juniper-garden/twig_temp_humidity_sensor/a-SEM-of-PTFE-tape-TaegaSeal-and-b-PTFE-membrane-Millipore-Although-PTFE-tape.png

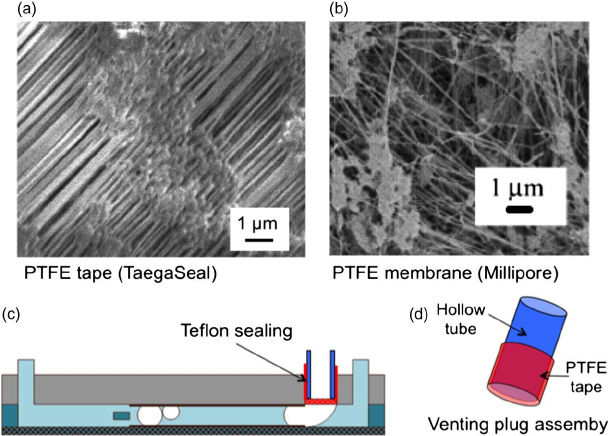
a-SEM-of-PTFE-tape-TaegaSeal-and-b-PTFE-membrane-Millipore-Although-PTFE-tape.png
