juniper-garden/twig_temp_humidity_sensor/temp sensor.png

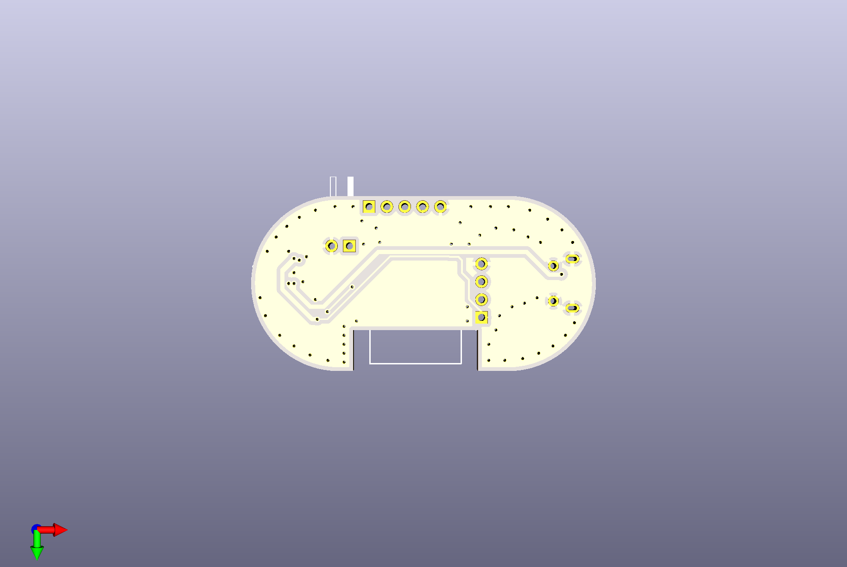
temp sensor.png
