juniper-garden/twig_temp_humidity_sensor/README.md

# twig_temp_humidity_sensor
Hardware files for the temperature and humidity sensor
