juniper-garden/twig_temp_humidity_sensor/Capture.PNG

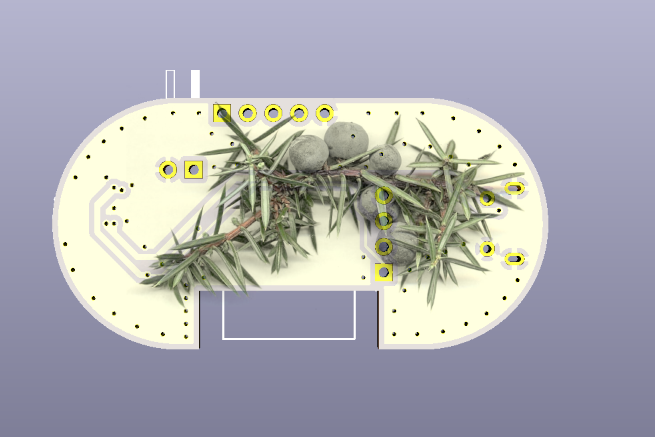
Capture.PNG
