juniper-garden/twig_temp_humidity_sensor/esp32 alignment error.PNG

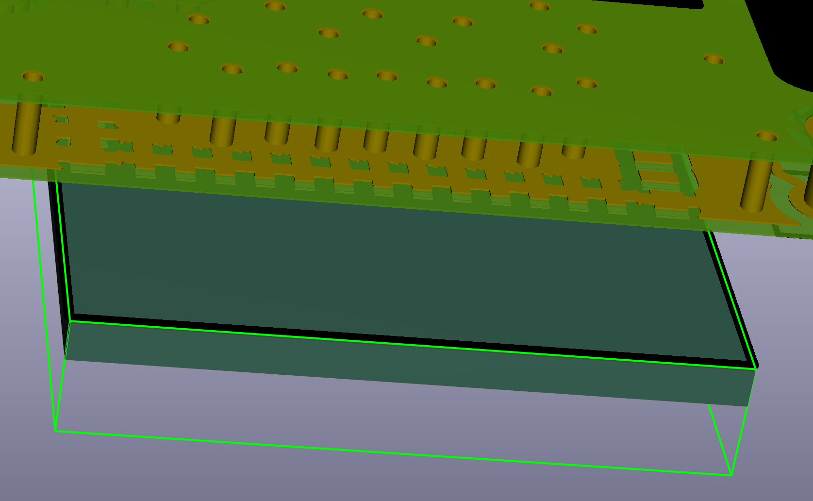
esp32 alignment error.PNG
