juniper-garden/twig_temp_humidity_sensor/gerbers.png_Combined_Bottom.png

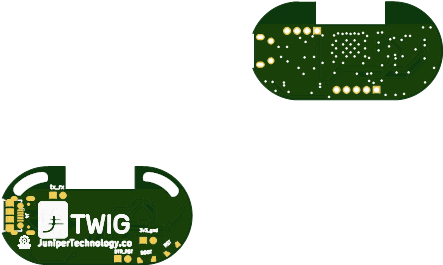
gerbers.png_Combined_Bottom.png
