juniper-garden/twig_temp_humidity_sensor/gerbers.png_Combined_Top.png

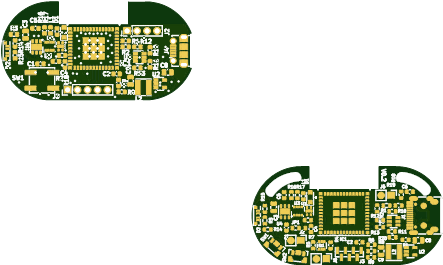
gerbers.png_Combined_Top.png
