juniper-garden/twig_temp_humidity_sensor/overmold notes.PNG

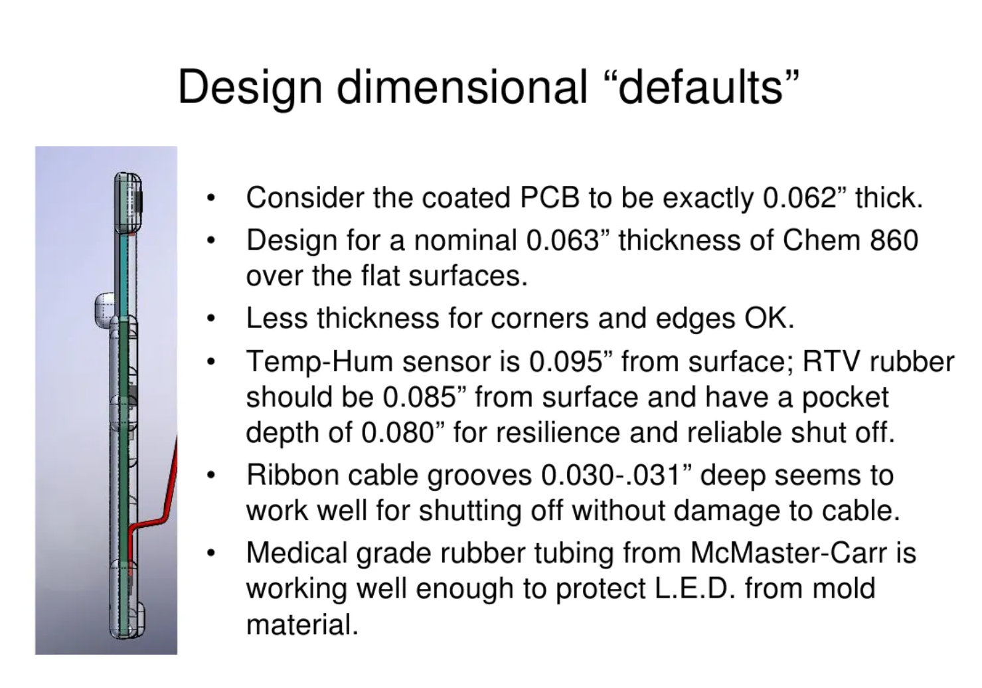
overmold notes.PNG
