juniper-garden/twig_temp_humidity_sensor/overmolding/overmolding suggestions.png

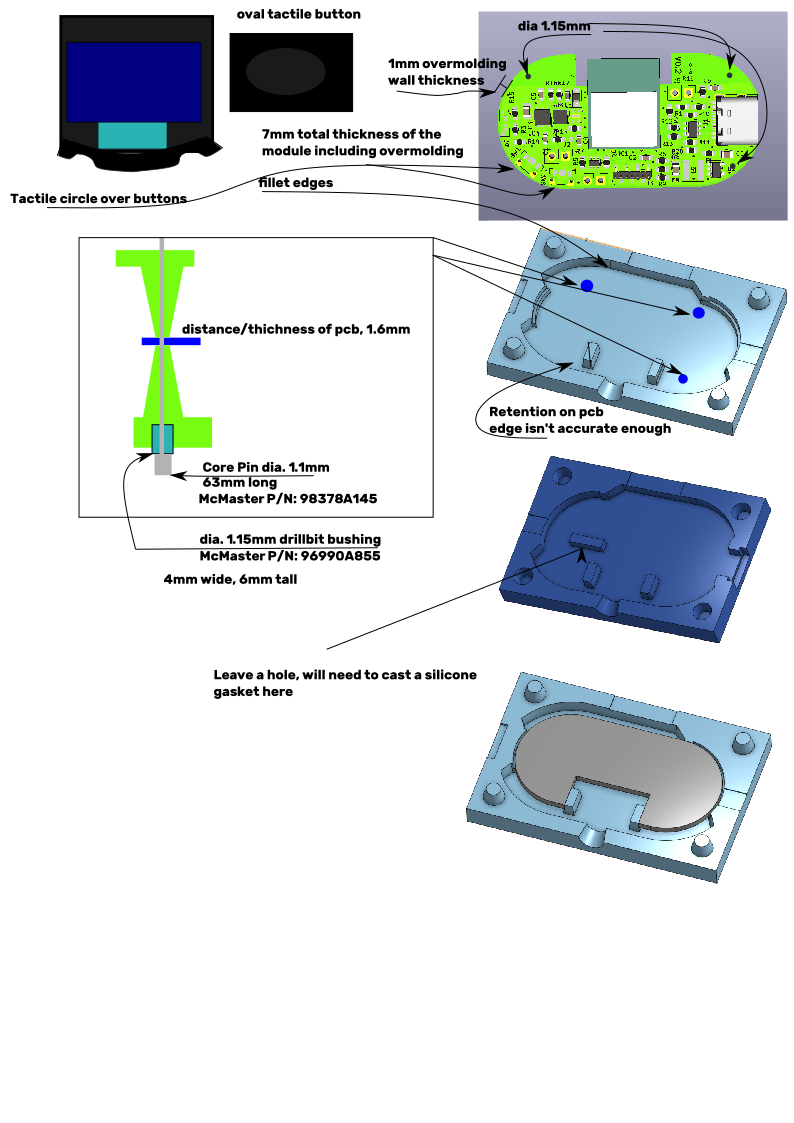
overmolding/overmolding suggestions.png
