juniper-garden/twig_temp_humidity_sensor/overmolding/tek bond 7718.jpg

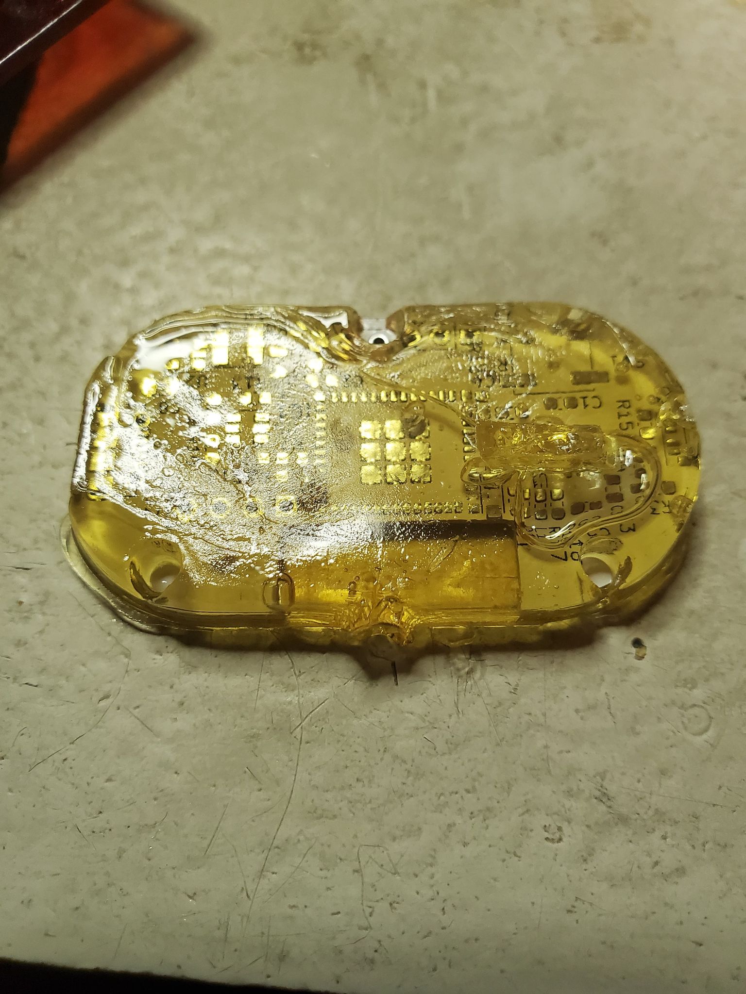
overmolding/tek bond 7718.jpg
