juniper-garden/twig_temp_humidity_sensor/panelized/frame/frame settings.PNG

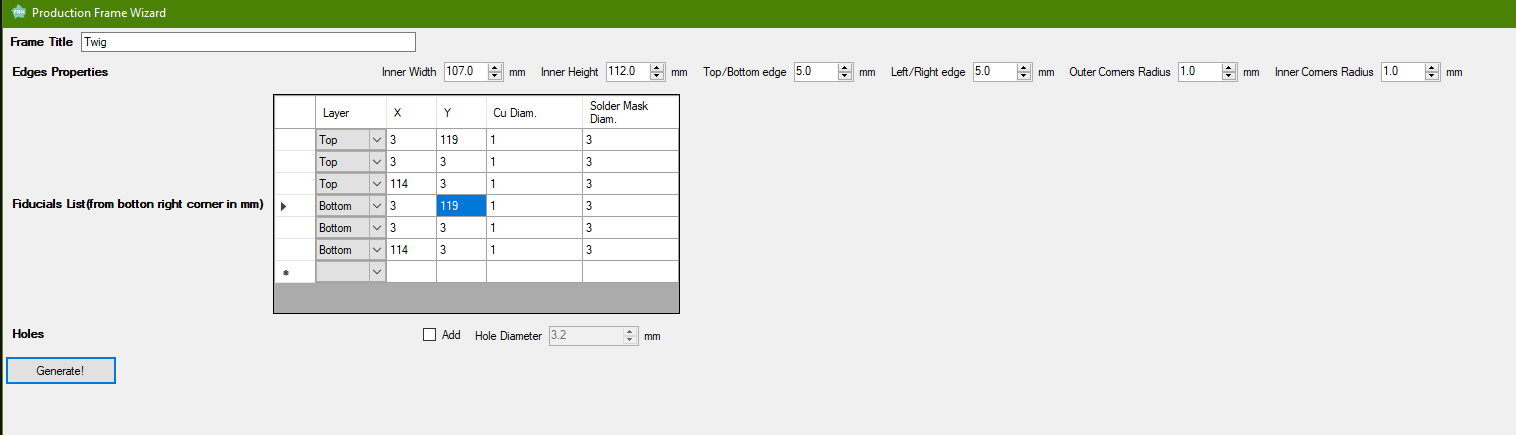
panelized/frame/frame settings.PNG
