juniper-garden/twig_temp_humidity_sensor/panelized/frame/twig frame_bottom_XRAY.png

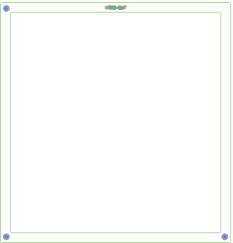
panelized/frame/twig frame_bottom_XRAY.png
