juniper-garden/twig_temp_humidity_sensor/panelized/twig_panelized_Combined_Top.png

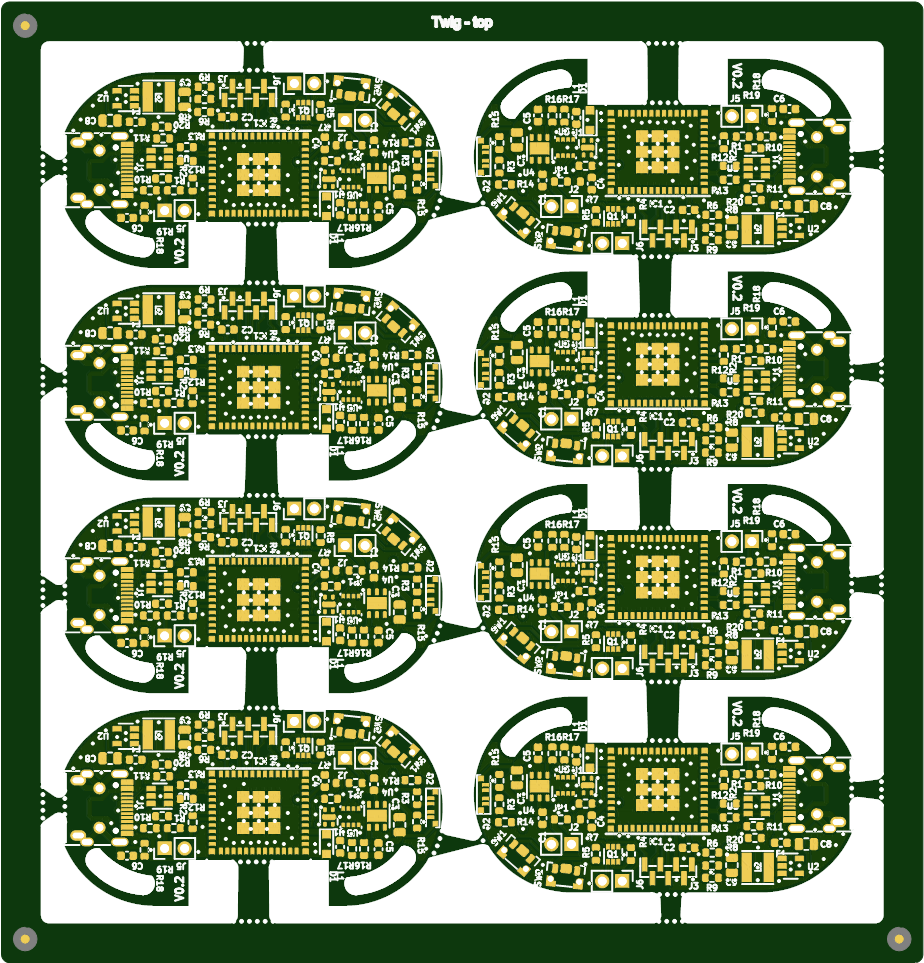
panelized/twig_panelized_Combined_Top.png
