juniper-garden/twig_temp_humidity_sensor/BOM/temp sensor_0v2.xls

Collated Components:
Item | diff from 0.1 | Notes | Qty | Reference(s) | Value | Footprint | Datasheet | Alt Part Number 2 | Alt Part Number 3 | Alternate Part Number 1 | Description | Digikey Part Number | Height | Manufacturer_Name | Manufacturer_Part_Number | Mouser Part Number | Mouser Price/Stock | JLPCB | JLPCB Extended Part
1 | none |  | 4 | C1, C2, C4, C5 | 0.1u | Capacitor_SMD:C_0603_1608Metric | https://www.mouser.com/datasheet/2/396/taiyo_yuden_12132018_mlcc11_hq_e-1510082.pdf |  | CC0603KRX7R9BB104 |  | Multilayer Ceramic Capacitors MLCC - SMD/SMT 0603 16VDC 0.1uF 10% X7R AEC-Q200 |  | 0.9 | Taiyo Yuden | EMK107B7104KAHT | 963-EMK107B7104KAHT | $0.10/110000 | C14663
2 | none |  | 2 | C3, C9 | 10u | Capacitor_SMD:C_0805_2012Metric | https://www.mouser.com/datasheet/2/396/mlcc02_e-1307760.pdf |  | CL21A106KAYNNNE |  | Multilayer Ceramic Capacitors MLCC - SMD/SMT 0805 10VDC 10uF 20% X5R |  |  | Taiyo Yuden | LMK212ABJ106MG-T | 963-LMK212ABJ106MG-T | $0.13/104348 | C15850
3 | yes |  | 1 | C6 | 0.01u | Capacitor_SMD:C_0603_1608Metric | https://www.mouser.com/datasheet/2/396/taiyo_yuden_12132018_mlcc11_hq_e-1510082.pdf |  | 0603B103K500NT |  | Multilayer Ceramic Capacitors MLCC - SMD/SMT 0603 16VDC 0.01uF 10% X7R AEC-Q200 |  | 0.9 | Taiyo Yuden | EMK107B7104KAHT | 963-EMK107B7104KAHT | $0.10/110000 | C57112
4 | none |  | 1 | C8 | 4.7u | Capacitor_SMD:C_0805_2012Metric | https://www.mouser.com/datasheet/2/396/mlcc02_e-1307760.pdf |  | CL10A106KP8NNNC |  | Multilayer Ceramic Capacitors MLCC - SMD/SMT 0603 6.3VDC 4.7uF 10% X6S |  |  | Taiyo Yuden | JMK107C6475KA-T | 963-JMK107C6475KA-T | $0.16/1200 | C19702
5 | none |  | 1 | D1 | 3.3v_TVS | Diode_SMD:D_SOD-323_HandSoldering | https://www.mouser.com/datasheet/2/115/SD03C-1594733.pdf |  | TPUSBLC6-2SC6 |  | ESD Suppressors / TVS Diodes Surge Protection PP |  |  | Diodes Incorporated | SD03C-7 | 621-SD03C-7 | $0.37/852 | C558442 | Extended
6 | none |  | 1 | D2 | QLS6A | LED_SMD:LED_Cree-PLCC6_4.7x1.5mm | https://www.mouser.com/datasheet/2/723/1397_QLS6BFKW-2257848.pdf |  |  |  | Standard LEDs - SMD RGB Side View |  | 1.33 | Cree LED | QLS6A-FKW-CNSNSF043 | 941-QLS6AFKWNSNSF043 | $0.40/29,835 | N/A
7 | yes |  | 1 | F1 | 6V 0.5A | Fuse:Fuse_0603_1608Metric | https://www.mouser.com/datasheet/2/54/mffsmf-777670.pdf |  |  |  | Resettable Fuses - PPTC 6Volts 40A |  |  | Bourns | MF-FSMF025X-2 | 652-MF-FSMF025X-2 | $0.79/2555 | C207011
8 | none | Pref: ESP32-C3-MINI-1-H4 | 1 | IC1 | ESP32-C3-MINI-1 | Twig:ESP32C3MINI1 | https://www.espressif.com/sites/default/files/documentation/esp32-c3-mini-1_datasheet_en.pdf |  |  | ESP32-PICO-MINI-02 | Smallsized module with onboard PCB antenna |  | 2.55 | Espressif Systems | ESP32-C3-MINI-1-H4 | 356-ESP32-C3-MINI1H4 | $1.90/0 | C2838502 | Extended
9 | yes |  | 1 | J1 | USB_C_Receptacle_USB2.0 | Connector_USB:USB_C_Receptacle_HRO_TYPE-C-31-M-12 | https://www.usb.org/sites/default/files/documents/usb_type-c.zip |  |  | U262-161N-4BVC11 | USB Connectors USB Type C,2.0, Rec, SMT,TH Shell Stakes |  |  | GCT | USB4105-GF-A | 640-USB4105-GF-A | $0.81 | C136423
10 | yes | No Place | 3 | J2, J5, J6 | Conn_01x02_Male | Connector_PinHeader_2.54mm:PinHeader_1x02_P2.54mm_Vertical | ~ |  |  |  |  |  |  |  |  |  |  | N/A
11 | yes | No Place | 1 | J3 | Conn_01x06_Male | Connector_PinHeader_1.00mm:PinHeader_1x07_P1.00mm_Vertical_SMD_Pin1Right | ~ |  |  |  |  |  |  |  |  |  |  | N/A
12 | none | No Place | 1 | J4 | USB_B_Micro | Connector_USB:USB_Micro-B_Molex-105017-0001 | https://www.mouser.com/datasheet/2/276/1/1050170001_IO_CONNECTORS-230168.pdf |  |  |  | USB Connectors MICRO USB B RECPT BTTM MNT SMT TH TABS |  |  | Molex | 105017-0001 | 538-105017-0001 | $0.88/15,819 | N/A
13 | yes | No Place | 1 | JP1 | Jumper_3_Bridged12 | Twig:Jumper_0603_1608Metric | ~ |  |  |  |  |  |  |  |  |  |  | N/A
14 | none |  | 1 | L1 | L_Core_Ferrite_Small | Inductor_SMD:L_0603_1608Metric | ~ |  |  |  | Ferrite Beads 100ohms 2A 40mOhms 0603 Ferrite Chip |  |  | TDK | MPZ1608Y101BTA00 | 810-MPZ1608Y101BTA00 |  | C96995
15 | none |  | 1 | L2 | 2.2uH | Inductor_SMD:L_Taiyo-Yuden_MD-4040 | https://www.mouser.com/datasheet/2/396/wound09_e-1396591.pdf |  |  |  | Fixed Inductors 4040 2.2uH 79mOhms +/-20%Tol 2.8A HiCur |  | 2 | Taiyo Yuden | MDMK4040T2R2MM | 963-MDMK4040T2R2MM | $0.78/678 | C142141
16 | yes |  | 1 | Q1 | BC847BDW1 | Package_TO_SOT_SMD:SOT-363_SC-70-6 | http://www.onsemi.com/pub_link/Collateral/BC846BDW1T1-D.PDF |  |  |  |  |  |  |  | BC847BDW1T1G | 863-BC847BDW1T1G |  | C426871
17 | none |  | 2 | R1, R2 | 499R | Resistor_SMD:R_0603_1608Metric | https://www.mouser.com/datasheet/2/54/crxxxxx-1858361.pdf |  |  |  | Thick Film Resistors - SMD 499 ohm 1% |  |  | Bourns | CR0603-FX-4990ELF | 652-CR0603FX-4990ELF | $0.10/19000 | C23065
18 | none |  | 1 | R3 | 200r | Resistor_SMD:R_0603_1608Metric | https://www.mouser.com/datasheet/2/54/crxxxxx-1858361.pdf |  |  |  | Thick Film Resistors - SMD 200 OHM 1% |  |  | Bourns | CR0603-FX-2000ELF | 652-CR0603-FX2000ELF | $0.10/78000 | C430229
19 | yes |  | 6 | R4, R5, R6, R7, R16, R17 | 10K | Resistor_SMD:R_0603_1608Metric | https://www.mouser.com/datasheet/2/447/Yageo_03_18_2021_PYu_RC_Group_51_RoHS_L_11-2199992.pdf |  |  |  | Thick Film Resistors - SMD 10 kOhms 100 mW 0603 5% |  |  | Yageo | ESR03EZPJ103 | 755-ESR03EZPJ103 | $0.10/256000 | C25804
20 | yes |  | 2 | R8, R18 | 680k | Resistor_SMD:R_0603_1608Metric | https://www.mouser.com/datasheet/2/447/Yageo_03_18_2021_PYu_RC_Group_51_RoHS_L_11-2199992.pdf |  |  |  | Thick Film Resistors - SMD 680 kOhms 100-200 mW 0603 1% |  |  | Yageo | RC0603FR-13680KL | 603-RC0603FR-13680KL | $0.10/100000 | C25822
21 | none |  | 1 | R9 | 150K | Resistor_SMD:R_0603_1608Metric | https://www.mouser.com/datasheet/2/447/Yageo_03_18_2021_PYu_RC_Group_51_RoHS_L_11-2199992.pdf |  |  |  | Thick Film Resistors - SMD 150 kOhms 100mW 0603 1% |  |  | Yageo | RC0603FR-07150KL | 603-RC0603FR-07150KL | $0.10/100000 | C22807
22 | none |  | 2 | R10, R11 | 15K | Resistor_SMD:R_0603_1608Metric | https://www.mouser.com/datasheet/2/447/Yageo_03_18_2021_PYu_RC_Group_51_RoHS_L_11-2199992.pdf |  |  |  | Thick Film Resistors - SMD 15 kOhms 100-200 mW 0603 1% |  |  | Yageo | RC0603FR-1315KL | 603-RC0603FR-1315KL | $0.10/78000 | C22809
23 | none |  | 2 | R12, R13 | 27r | Resistor_SMD:R_0603_1608Metric | https://www.mouser.com/datasheet/2/219/RK73B-1825463.pdf |  |  |  | Thick Film Resistors - SMD 1/8W 27 OHM 5% |  |  | KOA Speer | RK73B1JTTDD270J | 660-RK73B1JTTDD270J | $0.10/100000 | C25190
24 | none |  | 2 | R14, R15 | 100r | Resistor_SMD:R_0603_1608Metric | https://www.mouser.com/datasheet/2/447/Yageo_03_18_2021_PYu_RC_Group_51_RoHS_L_11-2199992.pdf |  |  |  | Thick Film Resistors - SMD 100 Ohms 100 mW 0603 5% |  |  | Yageo | RC0603JR-07100RL | 603-RC0603JR-07100RL | $0.10/2,633,578 | C22775
25 | yes |  | 2 | R19, R20 | 5.1k | Resistor_SMD:R_0603_1608Metric | https://www.mouser.com/datasheet/2/447/Yageo_03_18_2021_PYu_RC_Group_51_RoHS_L_11-2199992.pdf |  |  |  | Thick Film Resistors - SMD 5.1K ohm 1% |  |  | Bourns | CR0603-FX-5101ELF | 652-CR0603FX-5101ELF | $0.10/78000 | C23186
26 | yes |  | 2 | SW1, SW2 | SW_Push_Right_Angle | Twig:SW_Push_1P1T-MP_NO_Horizontal_TL6340 | https://sten-eswitch-13110800-production.s3.amazonaws.com/system/asset/product_line/data_sheet/256/TL6340.pdf |  | SKTDLHE010 | EVP-AKE31A | Tactile Switch SPST-NO Side Actuated Surface Mount, Right Angle | 141-TL6340AF160QGCT-ND |  | E-Switch | TL6340AF160QG |  | $0.48/10000 | C380198 | Extended
27 | none | No Place – alt sensor | 1 | U1 | SHTC3 | Sensor_Humidity:Sensirion_DFN-4-1EP_2x2mm_P1mm_EP0.7x1.6mm | https://www.mouser.com/datasheet/2/682/seri_s_a0003561073_1-2291167.pdf |  |  |  | Board Mount Humidity Sensors Humidity and Temperature Sensor |  |  | Sensirion | SHTC3 | 403-SHTC3 | $2.44/6,227 | C194656 | Extended
28 | none |  | 1 | U2 | TLV62569DBV | Package_TO_SOT_SMD:SOT-23-5 | http://www.ti.com/lit/ds/symlink/tlv62569.pdf |  |  | MP2128DT-LF-Z | Switching Voltage Regulators 2.5V-5.5V input, 2-A high efficiency step-down buck converter in |  | b2.9/s3.5 | Texas Instruments | TLV62569DBVR | 595-TLV62569DBVR | $0.60/0 | C141836 | Extended
29 | none | Pref: BME280 | 1 | U3 | BME280 | Package_LGA:Bosch_LGA-8_2.5x2.5mm_P0.65mm_ClockwisePinNumbering | https://ae-bst.resource.bosch.com/media/_tech/media/datasheets/BST-BME280-DS002.pdf |  |  |  | MEMS humidity, pressure and temperature sensor |  |  | Bosch Sensortec | BME280 | 262-BME280 | $5.78/0 | C92489 | Extended
30 | none | No Place – alt sensor | 1 | U4 | Si7020-A20 | Package_DFN_QFN:DFN-6-1EP_3x3mm_P1mm_EP1.5x2.4mm | https://www.silabs.com/documents/public/data-sheets/Si7020-A20.pdf | ASAIR | HDC1080 | AHT20 | Digital RH ( 4% max) & temperature sensor, |  | 0.75 | Silicon Labs | SI7020-A20-GMR | 634-SI7020-A20-GMR | $2.57/0 | C430229 | Extended
31 | none |  | 1 | U5 | SN65220 | Package_TO_SOT_SMD:SOT-23-6 | http://www.ti.com/lit/ds/symlink/sn65220.pdf |  |  |  | ESD Suppressors / TVS Diodes Single USB Port |  |  | Texas Instruments | SN65220DBVT | 595-SN65220DBVT | $1.03/12.700 | C350555 | Extended
