juniper-garden/twig_temp_humidity_sensor/BOM/temp sensor_0v3.xls

Source: | Y:\Juniper Garden\Twig\temp sensor.kicad_sch
Date: | 3/23/2022 12:52:19 AM
Tool: | Eeschema (6.0.0)
Generator: | C:\Program Files\KiCad\6.0\bin\scripting\plugins/bom_csv_grouped_by_value.py
Component Count: | 53
Individual Components:
Item | Qty | Reference(s) | Value | LibPart | Footprint | Datasheet | Alt Part Number 3 | Alternate Part Number 1 | Configuration | Description | Digikey Part Number | Height | MANUFACTURER | MAXIMUM_PACKAGE_HEIGHT | Manufacturer_Name | Manufacturer_Part_Number | Mouser Part Number | Mouser Price/Stock | PARTREV | STANDARD
 |  | C1 | 0.1u | temp-sensor-rescue:C_Small-Device-temp-sensor-rescue | Capacitor_SMD:C_0402_1005Metric |  |  |  | all | Multilayer Ceramic Capacitors MLCC - SMD/SMT 16VDC 0.1uF 10% X7R AEC-Q200 | 1276-1001-1-ND | 0.9 |  |  | Taiyo Yuden | EMK105B7104KVHF | 963-EMK105B7104KVHF | $0.10/110000 | V3
 |  | C2 | 0.1u | temp-sensor-rescue:C_Small-Device-temp-sensor-rescue | Capacitor_SMD:C_0402_1005Metric |  |  |  | all | Multilayer Ceramic Capacitors MLCC - SMD/SMT 16VDC 0.1uF 10% X7R AEC-Q200 | 1276-1001-1-ND | 0.9 |  |  | Taiyo Yuden | EMK105B7104KVHF | 963-EMK105B7104KVHF | $0.10/110000 | V3
 |  | C3 | 10u | temp-sensor-rescue:C_Small-Device-temp-sensor-rescue | Capacitor_SMD:C_1206_3216Metric_Pad1.42x1.75mm_HandSolder | https://www.mouser.com/datasheet/2/396/mlcc02_e-1307760.pdf |  |  | all | Multilayer Ceramic Capacitors MLCC - SMD/SMT 0805 10VDC 10uF 20% X5R |  |  |  |  | Taiyo Yuden | LMK212ABJ106MG-T | 963-LMK212ABJ106MG-T | $0.13/104348
 |  | C4 | 0.1u | temp-sensor-rescue:C_Small-Device-temp-sensor-rescue | Capacitor_SMD:C_0402_1005Metric |  |  |  | all | Multilayer Ceramic Capacitors MLCC - SMD/SMT 16VDC 0.1uF 10% X7R AEC-Q200 | 1276-1001-1-ND | 0.9 |  |  | Taiyo Yuden | EMK105B7104KVHF | 963-EMK105B7104KVHF | $0.10/110000 | V3
 |  | C5 | 0.1u | temp-sensor-rescue:C_Small-Device-temp-sensor-rescue | Capacitor_SMD:C_0402_1005Metric |  |  |  | all | Multilayer Ceramic Capacitors MLCC - SMD/SMT 16VDC 0.1uF 10% X7R AEC-Q200 | 1276-1001-1-ND | 0.9 |  |  | Taiyo Yuden | EMK105B7104KVHF | 963-EMK105B7104KVHF | $0.10/110000 | V3
 |  | C6 | 0.01u | temp-sensor-rescue:C_Small-Device-temp-sensor-rescue | Capacitor_SMD:C_0402_1005Metric | https://www.mouser.com/datasheet/2/396/taiyo_yuden_12132018_mlcc11_hq_e-1510082.pdf |  |  | all | Multilayer Ceramic Capacitors MLCC - SMD/SMT 16VDC 0.1uF 10% X7R AEC-Q200 |  | 0.9 |  |  | Taiyo Yuden | EMK105B7103KVHF | 963-EMK105B7103KVHF | $0.10/110000 | V3
 |  | C7 | 1u | temp-sensor-rescue:C_Small-Device-temp-sensor-rescue | Capacitor_SMD:C_0603_1608Metric |  |  |  | all | Multilayer Ceramic Capacitors MLCC - SMD/SMT 16VDC 1uF 10% X7R |  |  |  |  | Taiyo Yuden | EMK107B7105KA-T | 963-EMK107B7105KA-T | $0.10/110000
 |  | C8 | 4.7u | temp-sensor-rescue:C_Small-Device-temp-sensor-rescue | Capacitor_SMD:C_0805_2012Metric | https://www.mouser.com/datasheet/2/396/mlcc02_e-1307760.pdf |  |  | all | Multilayer Ceramic Capacitors MLCC - SMD/SMT 0603 6.3VDC 4.7uF 10% X6S |  |  |  |  | Taiyo Yuden | JMK107C6475KA-T | 963-JMK107C6475KA-T | $0.16/1200
 |  | C9 | 10u | temp-sensor-rescue:C_Small-Device-temp-sensor-rescue | Capacitor_SMD:C_1206_3216Metric_Pad1.42x1.75mm_HandSolder | https://www.mouser.com/datasheet/2/396/mlcc02_e-1307760.pdf |  |  | all | Multilayer Ceramic Capacitors MLCC - SMD/SMT 0805 10VDC 10uF 20% X5R |  |  |  |  | Taiyo Yuden | LMK212ABJ106MG-T | 963-LMK212ABJ106MG-T | $0.13/104348
 |  | C10 | 0.1u | temp-sensor-rescue:C_Small-Device-temp-sensor-rescue | Capacitor_SMD:C_0402_1005Metric |  |  |  | all | Multilayer Ceramic Capacitors MLCC - SMD/SMT 16VDC 0.1uF 10% X7R AEC-Q200 | 1276-1001-1-ND | 0.9 |  |  | Taiyo Yuden | EMK105B7104KVHF | 963-EMK105B7104KVHF | $0.10/110000 | V3
 |  | D2 | QLS6A | LED:QLS6A-FKW | LED_SMD:LED_Cree-PLCC6_4.7x1.5mm | https://www.mouser.com/datasheet/2/723/1397_QLS6BFKW-2257848.pdf |  |  | all | Standard LEDs - SMD RGB Side View |  | 1.33 |  |  | Cree LED | QLS6A-FKW-CNSNSF043 | 941-QLS6AFKWNSNSF043 | $0.40/29,835
 |  | H1 | MountingHole | Mechanical:MountingHole | Twig:CorePin_1.15mm | ~ |  |  | all |  |  |  |  |  |  |  |  |  | V3
 |  | H2 | MountingHole | Mechanical:MountingHole | Twig:CorePin_1.15mm | ~ |  |  | all |  |  |  |  |  |  |  |  |  | V3
 |  | H3 | MountingHole | Mechanical:MountingHole | Twig:CorePin_1.15mm | ~ |  |  | all |  |  |  |  |  |  |  |  |  | V3
 |  | IC1 | ESP32-C3-MINI-1 | ESP32-C3-MINI-1:ESP32-C3-MINI-1 | Twig:ESP32C3MINI1 | https://www.espressif.com/sites/default/files/documentation/esp32-c3-mini-1_datasheet_en.pdf |  | ESP32-PICO-MINI-02 | all | Smallsized module with onboard PCB antenna |  | 2.55 |  |  | Espressif Systems | ESP32-C3-MINI-1-H4 | 356-ESP32-C3-MINI1H4 | $1.90/0
 |  | J1 | USB_C_Receptacle_USB2.0 | Connector:USB_C_Receptacle_USB2.0 | Connector_USB:USB_C_Receptacle_HRO_TYPE-C-31-M-12 | https://www.usb.org/sites/default/files/documents/usb_type-c.zip |  | U262-161N-4BVC11 | all | USB Connectors USB Type C,2.0, Rec, SMT,TH Shell Stakes |  |  |  |  | GCT | USB4105-GF-A | 640-USB4105-GF-A | $0.81
 |  | J2 | Conn_01x02_Male | Connector:Conn_01x02_Male | Connector_PinHeader_2.54mm:PinHeader_1x02_P2.54mm_Vertical_SMD_Pin1Left | ~ |  |  | all
 |  | J3 | Conn_01x06_Male | Connector_Generic:Conn_01x07 | Connector_PinHeader_1.00mm:PinHeader_1x07_P1.00mm_Vertical_SMD_Pin1Right | ~ |  |  | all
 |  | J4 | USB_B_Micro | twig:temp-sensor-rescue_USB_B_Micro-Connector | Connector_USB:USB_Micro-B_Molex-105017-0001 | https://www.mouser.com/datasheet/2/276/1/1050170001_IO_CONNECTORS-230168.pdf |  |  | all | USB Connectors MICRO USB B RECPT BTTM MNT SMT TH TABS |  |  |  |  | Molex | 105017-0001 | 538-105017-0001 | $0.88/15,819
 |  | J5 | Conn_01x02_Male | Connector:Conn_01x02_Male | Connector_PinHeader_2.54mm:PinHeader_1x02_P2.54mm_Vertical_SMD_Pin1Left | ~ |  |  | all
 |  | J6 | Conn_01x02_Male | Connector:Conn_01x02_Male | Connector_PinHeader_2.54mm:PinHeader_1x02_P2.54mm_Vertical_SMD_Pin1Left | ~ |  |  | all
 |  | L2 | 2.2uH | Device:L_Core_Ferrite_Small | Inductor_SMD:L_Taiyo-Yuden_MD-4040 | https://www.mouser.com/datasheet/2/396/wound09_e-1396591.pdf |  |  | all | Fixed Inductors 4040 2.2uH 79mOhms +/-20%Tol 2.8A HiCur |  | 2 |  |  | Taiyo Yuden | MDMK4040T2R2MM | 963-MDMK4040T2R2MM | $0.78/678
 |  | LOGO1 | Logo_Open_Hardware_Small | Graphic:Logo_Open_Hardware_Small | Twig:FabDrawing-2Layer-Metric | ~ |  |  | all
 |  | Q1 | BC847BDW1 | Transistor_BJT:BC847BDW1 | Package_TO_SOT_SMD:SOT-363_SC-70-6 | http://www.onsemi.com/pub_link/Collateral/BC846BDW1T1-D.PDF |  |  | all |  |  |  |  |  |  | BC847BDW1T1G | 863-BC847BDW1T1G
 |  | R1 | 499R | temp-sensor-rescue:R_Small_US-Device-temp-sensor-rescue | Resistor_SMD:R_0402_1005Metric | https://www.mouser.com/datasheet/2/54/crxxxxx-1858361.pdf |  | RC0402FR-07499RL | all | Thick Film Resistors - SMD 499 ohm 1% | 311-499LRCT-ND |  |  |  | Bourns | CR0603-FX-4990ELF | 652-CR0603FX-4990ELF | $0.10/19000 | V3
 |  | R2 | 499R | temp-sensor-rescue:R_Small_US-Device-temp-sensor-rescue | Resistor_SMD:R_0402_1005Metric | https://www.mouser.com/datasheet/2/54/crxxxxx-1858361.pdf |  | RC0402FR-07499RL | all | Thick Film Resistors - SMD 499 ohm 1% | 311-499LRCT-ND |  |  |  | Bourns | CR0603-FX-4990ELF | 652-CR0603FX-4990ELF | $0.10/19000 | V3
 |  | R3 | 200 | temp-sensor-rescue:R_Small_US-Device-temp-sensor-rescue | Resistor_SMD:R_0402_1005Metric | https://www.mouser.com/datasheet/2/54/crxxxxx-1858361.pdf |  | PFR05S-201-FNH | all | Thick Film Resistors - SMD 200 OHM 1% | 2037-PFR05S-201-FNHCT-ND |  |  |  | Bourns | CR0603-FX-2000ELF | 652-CR0603-FX2000ELF | $0.10/78000 | V3
 |  | R4 | 10K | temp-sensor-rescue:R_Small_US-Device-temp-sensor-rescue | Resistor_SMD:R_0402_1005Metric | https://www.mouser.com/datasheet/2/447/Yageo_03_18_2021_PYu_RC_Group_51_RoHS_L_11-2199992.pdf |  |  | all | Thick Film Resistors - SMD 10 kOhms 100 mW 5% |  |  |  |  | Yageo | ESR03EZPJ103 | 755-ESR03EZPJ103 | $0.10/256000 | V3
 |  | R5 | 10K | temp-sensor-rescue:R_Small_US-Device-temp-sensor-rescue | Resistor_SMD:R_0402_1005Metric | https://www.mouser.com/datasheet/2/447/Yageo_03_18_2021_PYu_RC_Group_51_RoHS_L_11-2199992.pdf |  |  | all | Thick Film Resistors - SMD 10 kOhms 100 mW 5% |  |  |  |  | Yageo | ESR03EZPJ103 | 755-ESR03EZPJ103 | $0.10/256000 | V3
 |  | R6 | NP | temp-sensor-rescue:R_Small_US-Device-temp-sensor-rescue | Resistor_SMD:R_0402_1005Metric | https://www.mouser.com/datasheet/2/447/Yageo_03_18_2021_PYu_RC_Group_51_RoHS_L_11-2199992.pdf |  |  | all | Thick Film Resistors - SMD 10 kOhms 100 mW 5% |  |  |  |  | Yageo | ESR03EZPJ103 | 755-ESR03EZPJ103 | $0.10/256000 | V3
 |  | R7 | 10K | temp-sensor-rescue:R_Small_US-Device-temp-sensor-rescue | Resistor_SMD:R_0402_1005Metric | https://www.mouser.com/datasheet/2/447/Yageo_03_18_2021_PYu_RC_Group_51_RoHS_L_11-2199992.pdf |  |  | all | Thick Film Resistors - SMD 10 kOhms 100 mW 5% |  |  |  |  | Yageo | ESR03EZPJ103 | 755-ESR03EZPJ103 | $0.10/256000 | V3
 |  | R8 | 680k | temp-sensor-rescue:R_Small_US-Device-temp-sensor-rescue | Resistor_SMD:R_0402_1005Metric | https://www.mouser.com/datasheet/2/447/Yageo_03_18_2021_PYu_RC_Group_51_RoHS_L_11-2199992.pdf |  |  | all | Thick Film Resistors - SMD 680 kOhms 100-200 mW 1% |  |  |  |  | Yageo | RC0603FR-13680KL | 603-RC0603FR-13680KL | $0.10/100000 | V3
 |  | R9 | 150K | temp-sensor-rescue:R_Small_US-Device-temp-sensor-rescue | Resistor_SMD:R_0402_1005Metric | https://www.mouser.com/datasheet/2/447/Yageo_03_18_2021_PYu_RC_Group_51_RoHS_L_11-2199992.pdf |  |  | all | Thick Film Resistors - SMD 150 kOhms 100mW 1% |  |  |  |  | Yageo | RC0603FR-07150KL | 603-RC0603FR-07150KL | $0.10/100000 | V3
 |  | R10 | 15K | temp-sensor-rescue:R_Small_US-Device-temp-sensor-rescue | Resistor_SMD:R_0402_1005Metric | https://www.mouser.com/datasheet/2/447/Yageo_03_18_2021_PYu_RC_Group_51_RoHS_L_11-2199992.pdf |  |  | all | Thick Film Resistors - SMD 15 kOhms 100-200 mW 1% |  |  |  |  | Yageo | RC0603FR-1315KL | 603-RC0603FR-1315KL | $0.10/78000 | V3
 |  | R11 | 15K | temp-sensor-rescue:R_Small_US-Device-temp-sensor-rescue | Resistor_SMD:R_0402_1005Metric | https://www.mouser.com/datasheet/2/447/Yageo_03_18_2021_PYu_RC_Group_51_RoHS_L_11-2199992.pdf |  |  | all | Thick Film Resistors - SMD 15 kOhms 100-200 mW 1% |  |  |  |  | Yageo | RC0603FR-1315KL | 603-RC0603FR-1315KL | $0.10/78000 | V3
 |  | R12 | 27 | temp-sensor-rescue:R_Small_US-Device-temp-sensor-rescue | Resistor_SMD:R_0402_1005Metric | https://www.mouser.com/datasheet/2/219/RK73B-1825463.pdf |  |  | all | Thick Film Resistors - SMD 1/8W 27 OHM 5% |  |  |  |  | KOA Speer | RK73B1JTTDD270J | 660-RK73B1JTTDD270J | $0.10/100000 | V3
 |  | R13 | 27 | temp-sensor-rescue:R_Small_US-Device-temp-sensor-rescue | Resistor_SMD:R_0402_1005Metric | https://www.mouser.com/datasheet/2/219/RK73B-1825463.pdf |  |  | all | Thick Film Resistors - SMD 1/8W 27 OHM 5% |  |  |  |  | KOA Speer | RK73B1JTTDD270J | 660-RK73B1JTTDD270J | $0.10/100000 | V3
 |  | R14 | 100 | temp-sensor-rescue:R_Small_US-Device-temp-sensor-rescue | Resistor_SMD:R_0402_1005Metric | https://www.mouser.com/datasheet/2/447/Yageo_03_18_2021_PYu_RC_Group_51_RoHS_L_11-2199992.pdf |  |  | all | Thick Film Resistors - SMD 100 Ohms 100 mW 5% |  |  |  |  | Yageo | RC0603JR-07100RL | 603-RC0603JR-07100RL | $0.10/2,633,578 | V3
 |  | R15 | 100 | temp-sensor-rescue:R_Small_US-Device-temp-sensor-rescue | Resistor_SMD:R_0402_1005Metric | https://www.mouser.com/datasheet/2/447/Yageo_03_18_2021_PYu_RC_Group_51_RoHS_L_11-2199992.pdf |  |  | all | Thick Film Resistors - SMD 100 Ohms 100 mW 5% |  |  |  |  | Yageo | RC0603JR-07100RL | 603-RC0603JR-07100RL | $0.10/2,633,578 | V3
 |  | R16 | 10K | temp-sensor-rescue:R_Small_US-Device-temp-sensor-rescue | Resistor_SMD:R_0402_1005Metric | https://www.mouser.com/datasheet/2/447/Yageo_03_18_2021_PYu_RC_Group_51_RoHS_L_11-2199992.pdf |  |  | all | Thick Film Resistors - SMD 10 kOhms 100 mW 5% |  |  |  |  | Yageo | ESR03EZPJ103 | 755-ESR03EZPJ103 | $0.10/256000 | V3
 |  | R17 | 10K | temp-sensor-rescue:R_Small_US-Device-temp-sensor-rescue | Resistor_SMD:R_0402_1005Metric | https://www.mouser.com/datasheet/2/447/Yageo_03_18_2021_PYu_RC_Group_51_RoHS_L_11-2199992.pdf |  |  | all | Thick Film Resistors - SMD 10 kOhms 100 mW 5% |  |  |  |  | Yageo | ESR03EZPJ103 | 755-ESR03EZPJ103 | $0.10/256000 | V3
 |  | R19 | 5.1k | temp-sensor-rescue:R_Small_US-Device-temp-sensor-rescue | Resistor_SMD:R_0402_1005Metric | https://www.mouser.com/datasheet/2/447/Yageo_03_18_2021_PYu_RC_Group_51_RoHS_L_11-2199992.pdf |  |  | all | Thick Film Resistors - SMD 5.1K ohm 1% |  |  |  |  | Bourns | CR0603-FX-5101ELF | 652-CR0603FX-5101ELF | $0.10/78000 | V3
 |  | R20 | 5.1k | temp-sensor-rescue:R_Small_US-Device-temp-sensor-rescue | Resistor_SMD:R_0402_1005Metric | https://www.mouser.com/datasheet/2/447/Yageo_03_18_2021_PYu_RC_Group_51_RoHS_L_11-2199992.pdf |  |  | all | Thick Film Resistors - SMD 5.1K ohm 1% |  |  |  |  | Bourns | CR0603-FX-5101ELF | 652-CR0603FX-5101ELF | $0.10/78000 | V3
 |  | R21 | 10K | temp-sensor-rescue:R_Small_US-Device-temp-sensor-rescue | Resistor_SMD:R_0402_1005Metric | https://www.mouser.com/datasheet/2/447/Yageo_03_18_2021_PYu_RC_Group_51_RoHS_L_11-2199992.pdf |  |  | all | Thick Film Resistors - SMD 10 kOhms 100 mW 5% |  |  |  |  | Yageo | ESR03EZPJ103 | 755-ESR03EZPJ103 | $0.10/256000 | V3
 |  | SW1 | SW_Push_Right_Angle | temp-sensor-rescue:SW_Push-Switch-temp-sensor-rescue | Twig:SW_Push_1P1T-MP_NO_Horizontal_TL6340 | https://sten-eswitch-13110800-production.s3.amazonaws.com/system/asset/product_line/data_sheet/256/TL6340.pdf | SKTDLHE010 | EVP-AKE31A | all | Tactile Switch SPST-NO Side Actuated Surface Mount, Right Angle | 141-TL6340AF160QGCT-ND |  |  |  | E-Switch | TL6340AF160QG |  | $0.48/10000
 |  | SW2 | SW_Push_Right_Angle | temp-sensor-rescue:SW_Push-Switch-temp-sensor-rescue | Twig:SW_Push_1P1T-MP_NO_Horizontal_TL6340 | https://sten-eswitch-13110800-production.s3.amazonaws.com/system/asset/product_line/data_sheet/256/TL6340.pdf | SKTDLHE010 | EVP-AKE31A | all | Tactile Switch SPST-NO Side Actuated Surface Mount, Right Angle | 141-TL6340AF160QGCT-ND |  |  |  | E-Switch | TL6340AF160QG |  | $0.48/10000
 |  | SYM1 | SYM_Arrow_Normal | Graphic:SYM_Arrow_Normal | Twig:Sensor Keepout block | ~
 |  | U1 | SHTC3 | ESP32-C3-MINI-1:SHTC1 | Sensor_Humidity:Sensirion_DFN-4-1EP_2x2mm_P1mm_EP0.7x1.6mm | https://www.mouser.com/datasheet/2/682/seri_s_a0003561073_1-2291167.pdf |  |  | 1,2 | Board Mount Humidity Sensors Humidity and Temperature Sensor |  |  |  |  | Sensirion | SHTC3 | 403-SHTC3 | $2.44/6,227
 |  | U2 | TLV62569DBV | temp-sensor-rescue:TLV62569DBV-Regulator_Switching-temp-sensor-rescue | Package_TO_SOT_SMD:SOT-23-5 | http://www.ti.com/lit/ds/symlink/tlv62569.pdf |  | MP2128DT-LF-Z | all | Switching Voltage Regulators 2.5V-5.5V input, 2-A high efficiency step-down buck converter in |  | b2.9/s3.5 |  |  | Texas Instruments | TLV62569DBVR | 595-TLV62569DBVR | $0.60/0
 |  | U3 | BME280 | temp-sensor-rescue:BME280-Sensor-temp-sensor-rescue | Package_LGA:Bosch_LGA-8_2.5x2.5mm_P0.65mm_ClockwisePinNumbering | https://ae-bst.resource.bosch.com/media/_tech/media/datasheets/BST-BME280-DS002.pdf |  |  | 2-BMP280,3-BME280,4-BME688 | MEMS humidity, pressure and temperature sensor |  |  |  |  | Bosch Sensortec | BME280 | 262-BME280 | $5.78/0
 |  | U4 | MIC5365-3.3YC5 | Regulator_Linear:MIC5365-3.3YC5 | Package_TO_SOT_SMD:SOT-353_SC-70-5 | http://ww1.microchip.com/downloads/en/DeviceDoc/mic5365.pdf |  |  | 4
 |  | U5 | SN65220 | twig:SN65220-Power_Protection_passthrough | Package_TO_SOT_SMD:SOT-23-6 | http://www.ti.com/lit/ds/symlink/sn65220.pdf |  |  | all | ESD Suppressors / TVS Diodes Single USB Port |  |  |  |  | Texas Instruments | SN65220DBVT | 595-SN65220DBVT | $1.03/12.700
 |  | U6 | AS7341-DLGT | AS7341-DLGT:AS7341-DLGT | Twig:PSON80P310X200X110-8N | https://www.mouser.com/datasheet/2/588/AMS_03152019_AS7341_DS000504_1_00-1891973.pdf |  |  | 4 |  |  |  | AMS | 1.1 mm |  |  |  |  | V3 | IPC7351B
Collated Components:
Item | Qty | Reference(s) | Value | LibPart | Footprint | Datasheet | Alt Part Number 3 | Alternate Part Number 1 | Configuration | Description | Digikey Part Number | Height | MANUFACTURER | MAXIMUM_PACKAGE_HEIGHT | Manufacturer_Name | Manufacturer_Part_Number | Mouser Part Number | Mouser Price/Stock | PARTREV | STANDARD
1 | 5 | C1, C2, C4, C5, C10 | 0.1u | temp-sensor-rescue:C_Small-Device-temp-sensor-rescue | Capacitor_SMD:C_0402_1005Metric |  |  |  | all | Multilayer Ceramic Capacitors MLCC - SMD/SMT 16VDC 0.1uF 10% X7R AEC-Q200 | 1276-1001-1-ND | 0.9 |  |  | Taiyo Yuden | EMK105B7104KVHF | 963-EMK105B7104KVHF | $0.10/110000 | V3
2 | 2 | C3, C9 | 10u | temp-sensor-rescue:C_Small-Device-temp-sensor-rescue | Capacitor_SMD:C_1206_3216Metric_Pad1.42x1.75mm_HandSolder | https://www.mouser.com/datasheet/2/396/mlcc02_e-1307760.pdf |  |  | all | Multilayer Ceramic Capacitors MLCC - SMD/SMT 0805 10VDC 10uF 20% X5R |  |  |  |  | Taiyo Yuden | LMK212ABJ106MG-T | 963-LMK212ABJ106MG-T | $0.13/104348
3 | 1 | C6 | 0.01u | temp-sensor-rescue:C_Small-Device-temp-sensor-rescue | Capacitor_SMD:C_0402_1005Metric | https://www.mouser.com/datasheet/2/396/taiyo_yuden_12132018_mlcc11_hq_e-1510082.pdf |  |  | all | Multilayer Ceramic Capacitors MLCC - SMD/SMT 16VDC 0.1uF 10% X7R AEC-Q200 |  | 0.9 |  |  | Taiyo Yuden | EMK105B7103KVHF | 963-EMK105B7103KVHF | $0.10/110000 | V3
4 | 1 | C7 | 1u | temp-sensor-rescue:C_Small-Device-temp-sensor-rescue | Capacitor_SMD:C_0603_1608Metric |  |  |  | all | Multilayer Ceramic Capacitors MLCC - SMD/SMT 16VDC 1uF 10% X7R |  |  |  |  | Taiyo Yuden | EMK107B7105KA-T | 963-EMK107B7105KA-T | $0.10/110000
5 | 1 | C8 | 4.7u | temp-sensor-rescue:C_Small-Device-temp-sensor-rescue | Capacitor_SMD:C_0805_2012Metric | https://www.mouser.com/datasheet/2/396/mlcc02_e-1307760.pdf |  |  | all | Multilayer Ceramic Capacitors MLCC - SMD/SMT 0603 6.3VDC 4.7uF 10% X6S |  |  |  |  | Taiyo Yuden | JMK107C6475KA-T | 963-JMK107C6475KA-T | $0.16/1200
6 | 1 | D2 | QLS6A | LED:QLS6A-FKW | LED_SMD:LED_Cree-PLCC6_4.7x1.5mm | https://www.mouser.com/datasheet/2/723/1397_QLS6BFKW-2257848.pdf |  |  | all | Standard LEDs - SMD RGB Side View |  | 1.33 |  |  | Cree LED | QLS6A-FKW-CNSNSF043 | 941-QLS6AFKWNSNSF043 | $0.40/29,835
7 | 3 | H1, H2, H3 | MountingHole | Mechanical:MountingHole | Twig:CorePin_1.15mm | ~ |  |  | all |  |  |  |  |  |  |  |  |  | V3
8 | 1 | IC1 | ESP32-C3-MINI-1 | ESP32-C3-MINI-1:ESP32-C3-MINI-1 | Twig:ESP32C3MINI1 | https://www.espressif.com/sites/default/files/documentation/esp32-c3-mini-1_datasheet_en.pdf |  | ESP32-PICO-MINI-02 | all | Smallsized module with onboard PCB antenna |  | 2.55 |  |  | Espressif Systems | ESP32-C3-MINI-1-H4 | 356-ESP32-C3-MINI1H4 | $1.90/0
9 | 1 | J1 | USB_C_Receptacle_USB2.0 | Connector:USB_C_Receptacle_USB2.0 | Connector_USB:USB_C_Receptacle_HRO_TYPE-C-31-M-12 | https://www.usb.org/sites/default/files/documents/usb_type-c.zip |  | U262-161N-4BVC11 | all | USB Connectors USB Type C,2.0, Rec, SMT,TH Shell Stakes |  |  |  |  | GCT | USB4105-GF-A | 640-USB4105-GF-A | $0.81
10 | 3 | J2, J5, J6 | Conn_01x02_Male | Connector:Conn_01x02_Male | Connector_PinHeader_2.54mm:PinHeader_1x02_P2.54mm_Vertical_SMD_Pin1Left | ~ |  |  | all
11 | 1 | J3 | Conn_01x06_Male | Connector_Generic:Conn_01x07 | Connector_PinHeader_1.00mm:PinHeader_1x07_P1.00mm_Vertical_SMD_Pin1Right | ~ |  |  | all
12 | 1 | J4 | USB_B_Micro | twig:temp-sensor-rescue_USB_B_Micro-Connector | Connector_USB:USB_Micro-B_Molex-105017-0001 | https://www.mouser.com/datasheet/2/276/1/1050170001_IO_CONNECTORS-230168.pdf |  |  | all | USB Connectors MICRO USB B RECPT BTTM MNT SMT TH TABS |  |  |  |  | Molex | 105017-0001 | 538-105017-0001 | $0.88/15,819
13 | 1 | L2 | 2.2uH | Device:L_Core_Ferrite_Small | Inductor_SMD:L_Taiyo-Yuden_MD-4040 | https://www.mouser.com/datasheet/2/396/wound09_e-1396591.pdf |  |  | all | Fixed Inductors 4040 2.2uH 79mOhms +/-20%Tol 2.8A HiCur |  | 2 |  |  | Taiyo Yuden | MDMK4040T2R2MM | 963-MDMK4040T2R2MM | $0.78/678
14 | 1 | LOGO1 | Logo_Open_Hardware_Small | Graphic:Logo_Open_Hardware_Small | Twig:FabDrawing-2Layer-Metric | ~ |  |  | all
15 | 1 | Q1 | BC847BDW1 | Transistor_BJT:BC847BDW1 | Package_TO_SOT_SMD:SOT-363_SC-70-6 | http://www.onsemi.com/pub_link/Collateral/BC846BDW1T1-D.PDF |  |  | all |  |  |  |  |  |  | BC847BDW1T1G | 863-BC847BDW1T1G
16 | 2 | R1, R2 | 499R | temp-sensor-rescue:R_Small_US-Device-temp-sensor-rescue | Resistor_SMD:R_0402_1005Metric | https://www.mouser.com/datasheet/2/54/crxxxxx-1858361.pdf |  | RC0402FR-07499RL | all | Thick Film Resistors - SMD 499 ohm 1% | 311-499LRCT-ND |  |  |  | Bourns | CR0603-FX-4990ELF | 652-CR0603FX-4990ELF | $0.10/19000 | V3
17 | 1 | R3 | 200 | temp-sensor-rescue:R_Small_US-Device-temp-sensor-rescue | Resistor_SMD:R_0402_1005Metric | https://www.mouser.com/datasheet/2/54/crxxxxx-1858361.pdf |  | PFR05S-201-FNH | all | Thick Film Resistors - SMD 200 OHM 1% | 2037-PFR05S-201-FNHCT-ND |  |  |  | Bourns | CR0603-FX-2000ELF | 652-CR0603-FX2000ELF | $0.10/78000 | V3
18 | 6 | R4, R5, R7, R16, R17, R21 | 10K | temp-sensor-rescue:R_Small_US-Device-temp-sensor-rescue | Resistor_SMD:R_0402_1005Metric | https://www.mouser.com/datasheet/2/447/Yageo_03_18_2021_PYu_RC_Group_51_RoHS_L_11-2199992.pdf |  |  | all | Thick Film Resistors - SMD 10 kOhms 100 mW 5% |  |  |  |  | Yageo | ESR03EZPJ103 | 755-ESR03EZPJ103 | $0.10/256000 | V3
19 | 1 | R6 | NP | temp-sensor-rescue:R_Small_US-Device-temp-sensor-rescue | Resistor_SMD:R_0402_1005Metric | https://www.mouser.com/datasheet/2/447/Yageo_03_18_2021_PYu_RC_Group_51_RoHS_L_11-2199992.pdf |  |  | all | Thick Film Resistors - SMD 10 kOhms 100 mW 5% |  |  |  |  | Yageo | ESR03EZPJ103 | 755-ESR03EZPJ103 | $0.10/256000 | V3
20 | 1 | R8 | 680k | temp-sensor-rescue:R_Small_US-Device-temp-sensor-rescue | Resistor_SMD:R_0402_1005Metric | https://www.mouser.com/datasheet/2/447/Yageo_03_18_2021_PYu_RC_Group_51_RoHS_L_11-2199992.pdf |  |  | all | Thick Film Resistors - SMD 680 kOhms 100-200 mW 1% |  |  |  |  | Yageo | RC0603FR-13680KL | 603-RC0603FR-13680KL | $0.10/100000 | V3
21 | 1 | R9 | 150K | temp-sensor-rescue:R_Small_US-Device-temp-sensor-rescue | Resistor_SMD:R_0402_1005Metric | https://www.mouser.com/datasheet/2/447/Yageo_03_18_2021_PYu_RC_Group_51_RoHS_L_11-2199992.pdf |  |  | all | Thick Film Resistors - SMD 150 kOhms 100mW 1% |  |  |  |  | Yageo | RC0603FR-07150KL | 603-RC0603FR-07150KL | $0.10/100000 | V3
22 | 2 | R10, R11 | 15K | temp-sensor-rescue:R_Small_US-Device-temp-sensor-rescue | Resistor_SMD:R_0402_1005Metric | https://www.mouser.com/datasheet/2/447/Yageo_03_18_2021_PYu_RC_Group_51_RoHS_L_11-2199992.pdf |  |  | all | Thick Film Resistors - SMD 15 kOhms 100-200 mW 1% |  |  |  |  | Yageo | RC0603FR-1315KL | 603-RC0603FR-1315KL | $0.10/78000 | V3
23 | 2 | R12, R13 | 27 | temp-sensor-rescue:R_Small_US-Device-temp-sensor-rescue | Resistor_SMD:R_0402_1005Metric | https://www.mouser.com/datasheet/2/219/RK73B-1825463.pdf |  |  | all | Thick Film Resistors - SMD 1/8W 27 OHM 5% |  |  |  |  | KOA Speer | RK73B1JTTDD270J | 660-RK73B1JTTDD270J | $0.10/100000 | V3
24 | 2 | R14, R15 | 100 | temp-sensor-rescue:R_Small_US-Device-temp-sensor-rescue | Resistor_SMD:R_0402_1005Metric | https://www.mouser.com/datasheet/2/447/Yageo_03_18_2021_PYu_RC_Group_51_RoHS_L_11-2199992.pdf |  |  | all | Thick Film Resistors - SMD 100 Ohms 100 mW 5% |  |  |  |  | Yageo | RC0603JR-07100RL | 603-RC0603JR-07100RL | $0.10/2,633,578 | V3
25 | 2 | R19, R20 | 5.1k | temp-sensor-rescue:R_Small_US-Device-temp-sensor-rescue | Resistor_SMD:R_0402_1005Metric | https://www.mouser.com/datasheet/2/447/Yageo_03_18_2021_PYu_RC_Group_51_RoHS_L_11-2199992.pdf |  |  | all | Thick Film Resistors - SMD 5.1K ohm 1% |  |  |  |  | Bourns | CR0603-FX-5101ELF | 652-CR0603FX-5101ELF | $0.10/78000 | V3
26 | 2 | SW1, SW2 | SW_Push_Right_Angle | temp-sensor-rescue:SW_Push-Switch-temp-sensor-rescue | Twig:SW_Push_1P1T-MP_NO_Horizontal_TL6340 | https://sten-eswitch-13110800-production.s3.amazonaws.com/system/asset/product_line/data_sheet/256/TL6340.pdf | SKTDLHE010 | EVP-AKE31A | all | Tactile Switch SPST-NO Side Actuated Surface Mount, Right Angle | 141-TL6340AF160QGCT-ND |  |  |  | E-Switch | TL6340AF160QG |  | $0.48/10000
27 | 1 | SYM1 | SYM_Arrow_Normal | Graphic:SYM_Arrow_Normal | Twig:Sensor Keepout block | ~
28 | 1 | U1 | SHTC3 | ESP32-C3-MINI-1:SHTC1 | Sensor_Humidity:Sensirion_DFN-4-1EP_2x2mm_P1mm_EP0.7x1.6mm | https://www.mouser.com/datasheet/2/682/seri_s_a0003561073_1-2291167.pdf |  |  | 1,2 | Board Mount Humidity Sensors Humidity and Temperature Sensor |  |  |  |  | Sensirion | SHTC3 | 403-SHTC3 | $2.44/6,227
29 | 1 | U2 | TLV62569DBV | temp-sensor-rescue:TLV62569DBV-Regulator_Switching-temp-sensor-rescue | Package_TO_SOT_SMD:SOT-23-5 | http://www.ti.com/lit/ds/symlink/tlv62569.pdf |  | MP2128DT-LF-Z | all | Switching Voltage Regulators 2.5V-5.5V input, 2-A high efficiency step-down buck converter in |  | b2.9/s3.5 |  |  | Texas Instruments | TLV62569DBVR | 595-TLV62569DBVR | $0.60/0
30 | 1 | U3 | BME280 | temp-sensor-rescue:BME280-Sensor-temp-sensor-rescue | Package_LGA:Bosch_LGA-8_2.5x2.5mm_P0.65mm_ClockwisePinNumbering | https://ae-bst.resource.bosch.com/media/_tech/media/datasheets/BST-BME280-DS002.pdf |  |  | 2-BMP280,3-BME280,4-BME688 | MEMS humidity, pressure and temperature sensor |  |  |  |  | Bosch Sensortec | BME280 | 262-BME280 | $5.78/0
31 | 1 | U4 | MIC5365-3.3YC5 | Regulator_Linear:MIC5365-3.3YC5 | Package_TO_SOT_SMD:SOT-353_SC-70-5 | http://ww1.microchip.com/downloads/en/DeviceDoc/mic5365.pdf |  |  | 4
32 | 1 | U5 | SN65220 | twig:SN65220-Power_Protection_passthrough | Package_TO_SOT_SMD:SOT-23-6 | http://www.ti.com/lit/ds/symlink/sn65220.pdf |  |  | all | ESD Suppressors / TVS Diodes Single USB Port |  |  |  |  | Texas Instruments | SN65220DBVT | 595-SN65220DBVT | $1.03/12.700
33 | 1 | U6 | AS7341-DLGT | AS7341-DLGT:AS7341-DLGT | Twig:PSON80P310X200X110-8N | https://www.mouser.com/datasheet/2/588/AMS_03152019_AS7341_DS000504_1_00-1891973.pdf |  |  | 4 |  |  |  | AMS | 1.1 mm |  |  |  |  | V3 | IPC7351B
