juniper-garden/twig_temp_humidity_sensor/BOM/temp sensor print_0v1.xls

Qty | Reference(s) | Value | Alt Part Number 3 | Alternate Part Number 1 | Description | Manufacturer_Part_Number | Mouser Part Number
4 | C1, C2, C4, C5 | 0.1u |  |  | Multilayer Ceramic Capacitors MLCC - SMD/SMT 0603 16VDC 0.1uF 10% X7R AEC-Q200 | EMK107B7104KAHT | 963-EMK107B7104KAHT
2 | C3, C9 | 10u |  |  | Multilayer Ceramic Capacitors MLCC - SMD/SMT 0805 10VDC 10uF 20% X5R | LMK212ABJ106MG-T | 963-LMK212ABJ106MG-T
1 | C8 | 4.7u |  |  | Multilayer Ceramic Capacitors MLCC - SMD/SMT 0603 6.3VDC 4.7uF 10% X6S | JMK107C6475KA-T | 963-JMK107C6475KA-T
1 | D1 | 3.3v_TVS |  |  | ESD Suppressors / TVS Diodes Surge Protection PP | SD03C-7 | 621-SD03C-7
1 | D2 | LED_RGB |  |  | Standard LEDs - SMD RGB Side View | QLS6A-FKW-CNSNSF043 | 941-QLS6AFKWNSNSF043
1 | IC1 | ESP32-C3-MINI-1 |  | ESP32-PICO-MINI-02 | Smallsized module with onboard PCB antenna | ESP32-C3-MINI-1-H4 | 356-ESP32-C3-MINI1H4
1 | J2 | Conn_01x04_Male
1 | J3 | Conn_01x05_Male
1 | J4 | USB_B_Micro |  |  | USB Connectors MICRO USB B RECPT BTTM MNT SMT TH TABS | 105017-0001 | 538-105017-0001
1 | L1 | L_Core_Ferrite_Small |  |  | Ferrite Beads 100ohms 2A 40mOhms 0603 Ferrite Chip | MPZ1608Y101BTA00 | 810-MPZ1608Y101BTA00
1 | L2 | 2.2uH |  |  | Fixed Inductors 4040 2.2uH 79mOhms +/-20%Tol 2.8A HiCur | MDMK4040T2R2MM | 963-MDMK4040T2R2MM
2 | R1, R2 | 499R |  |  | Thick Film Resistors - SMD 499 ohm 1% | CR0603-FX-4990ELF | 652-CR0603FX-4990ELF
1 | R3 | 200 |  |  | Thick Film Resistors - SMD 200 OHM 1% | CR0603-FX-2000ELF | 652-CR0603-FX2000ELF
3 | R7, R16, R17 | 10K |  |  | Thick Film Resistors - SMD 10 kOhms 100 mW 0603 5% | ESR03EZPJ103 | 755-ESR03EZPJ103
1 | R8 | 680k |  |  | Thick Film Resistors - SMD 680 kOhms 100-200 mW 0603 1% | RC0603FR-13680KL | 603-RC0603FR-13680KL
1 | R9 | 150K |  |  | Thick Film Resistors - SMD 150 kOhms 100mW 0603 1% | RC0603FR-07150KL | 603-RC0603FR-07150KL
2 | R10, R11 | 15K |  |  | Thick Film Resistors - SMD 15 kOhms 100-200 mW 0603 1% | RC0603FR-1315KL | 603-RC0603FR-1315KL
2 | R12, R13 | 27 |  |  | Thick Film Resistors - SMD 1/8W 27 OHM 5% | RK73B1JTTDD270J | 660-RK73B1JTTDD270J
2 | R14, R15 | 100 |  |  | Thick Film Resistors - SMD 100 Ohms 100 mW 0603 5% | RC0603JR-07100RL | 603-RC0603JR-07100RL
1 | R18 | 2.2K |  |  | Thick Film Resistors - SMD 0603 2.2KOHMS 5% 1/10WATT | CR0603-JW-222ELF | 652-CR0603-JW-222ELF
1 | SW1 | SW_Push |  |  | Tactile Switches 0.3mA 24VAC, 1.60N 3.5mmH, J lead, IP67 | KSC2TE01JLFS | 611-KSC2TE01JLFS
1 | U1 | SHTC3 |  |  | Board Mount Humidity Sensors Humidity and Temperature Sensor | SHTC3 | 403-SHTC3
1 | U2 | TLV62569DBV |  | MP2128DT-LF-Z | Switching Voltage Regulators 2.5V-5.5V input, 2-A high efficiency step-down buck converter in | TLV62569DBVR | 595-TLV62569DBVR
1 | U3 | BME280 |  |  | MEMS humidity, pressure and temperature sensor | BME280 | 262-BME280
1 | U4 | Si7020-A20 | HDC1080 | AHT20 | Digital RH ( 4% max) & temperature sensor, | SI7020-A20-GMR | 634-SI7020-A20-GMR
1 | U5 | SN65220 |  |  | ESD Suppressors / TVS Diodes Single USB Port | SN65220DBVT | 595-SN65220DBVT
