juniper-garden/twig_temp_humidity_sensor/HRO_TYPE-C-31-M-12.step

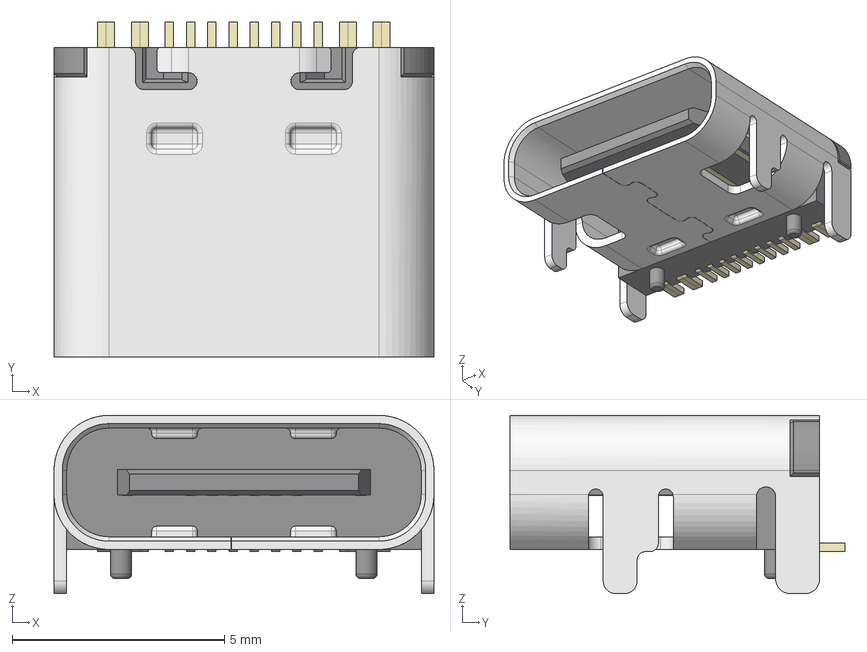
[picture p14: CAD file, 2023-05-17]
HRO_TYPE-C-31-M-12.step
8.95 x 7.90 x 4.20 mm
