juniper-garden/twig_temp_humidity_sensor/overmolding/Unnamed1-led_window_cutout001 (Solid).step

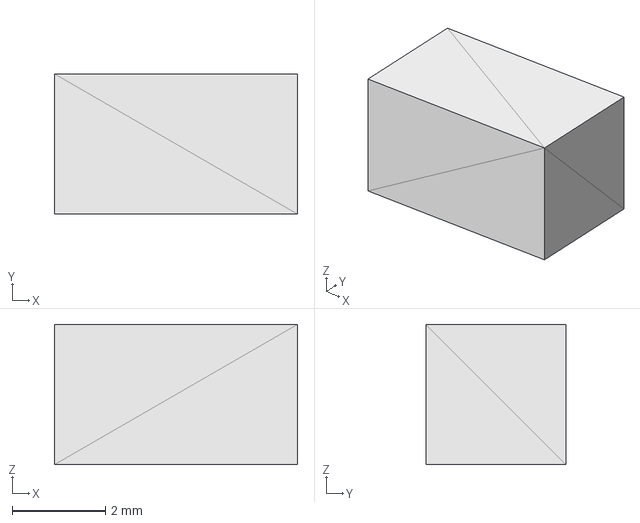
[picture p15: CAD file, 2023-05-17]
overmolding/Unnamed1-led_window_cutout001 (Solid).step
5.20 x 3.00 x 3.00 mm
