juniper-garden/twig_temp_humidity_sensor/ESP32-pico-mini-02 v2.step

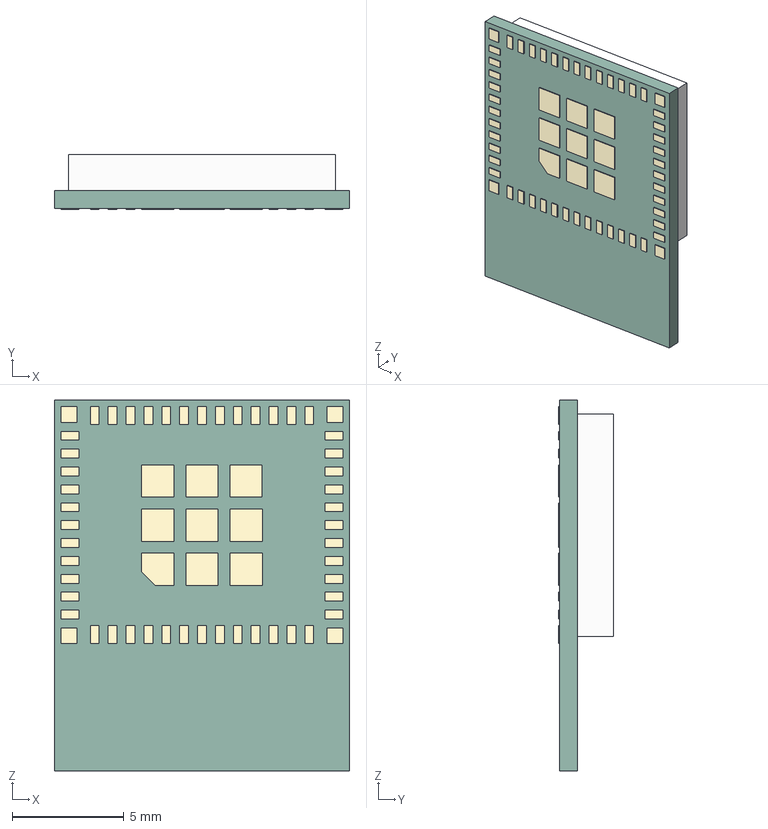
[picture p16: CAD file, 2023-05-17]
ESP32-pico-mini-02 v2.step
13.2 x 2.45 x 16.6 mm
FR4-PCB
ALU-CAP
Pads
