juniper-garden/twig_temp_humidity_sensor/overmolding/twig potting options.FCStd

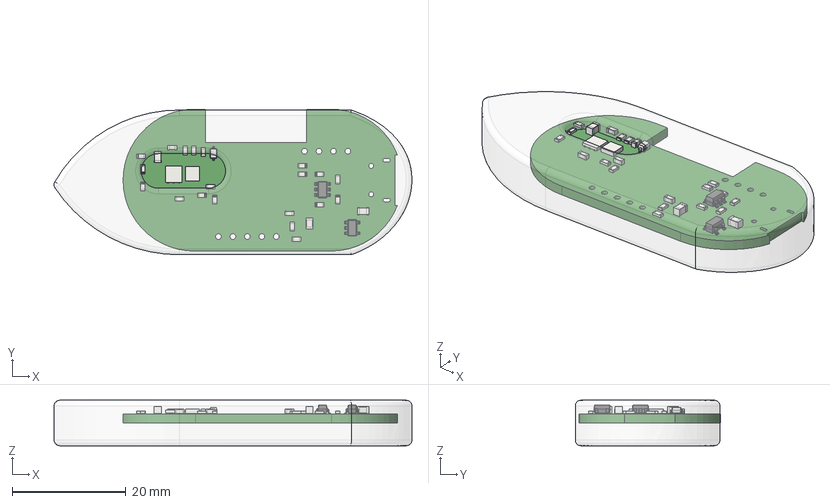
[picture p17: CAD file, 2023-05-17]
overmolding/twig potting options.FCStd
62.9 x 25.5 x 8.00 mm
