juniper-garden/twig_temp_humidity_sensor/overmolding/twig potting options edit.FCStd

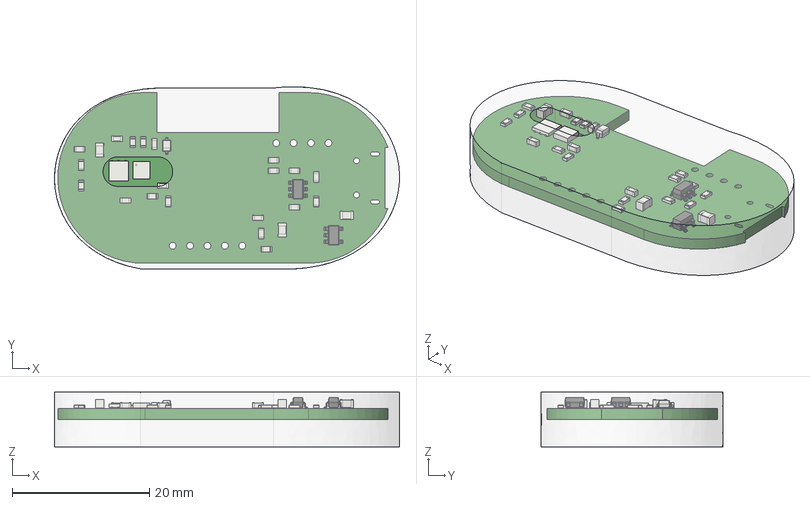
[picture p18: CAD file, 2023-05-17]
overmolding/twig potting options edit.FCStd
50.4 x 26.6 x 8.00 mm
