juniper-garden/twig_temp_humidity_sensor/TL6340AF160Q.stp

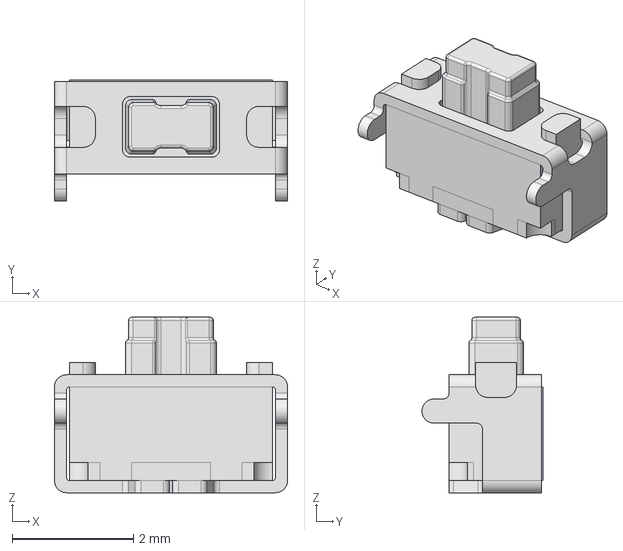
[picture p19: CAD file, 2023-05-17]
TL6340AF160Q.stp
3.85 x 2.00 x 2.90 mm
