juniper-garden/twig_temp_humidity_sensor/OSHW-Logo-R2000.dxf

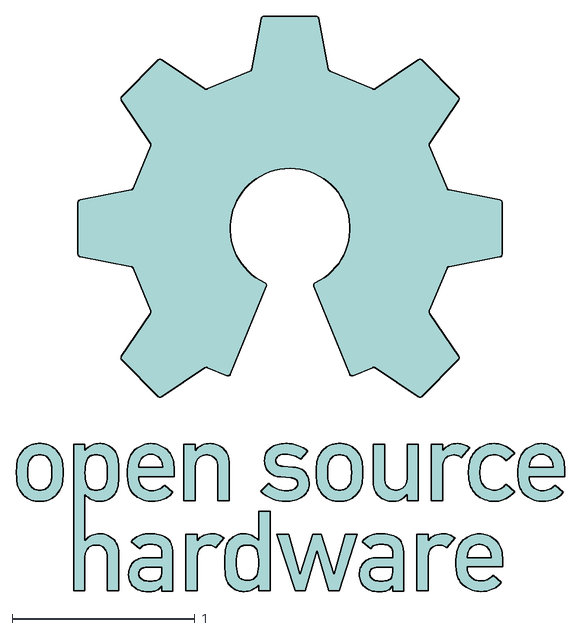
[picture p20: CAD file, 2023-05-17]
OSHW-Logo-R2000.dxf
3.00 x 3.15
