juniper-garden/twig_temp_humidity_sensor/overmolding/sensor window cutout.FCStd

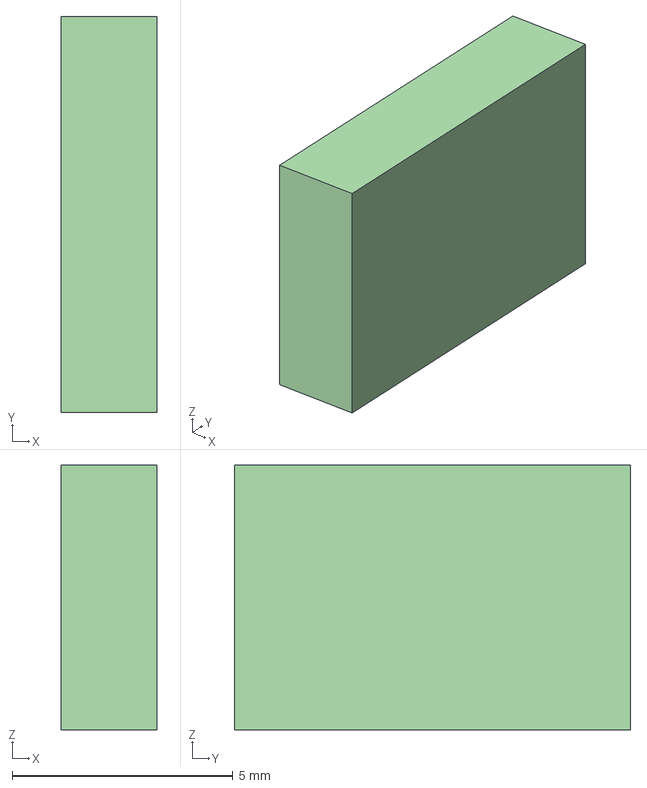
[picture p21: CAD file, 2023-05-17]
overmolding/sensor window cutout.FCStd
2.18 x 8.97 x 6.00 mm
sensor_window_cutout002
sensor_window_cutout002 (Solid)
sensor window cutout
sensor window cutout001
