juniper-garden/twig_temp_humidity_sensor/overmolding/led window cutout.FCStd

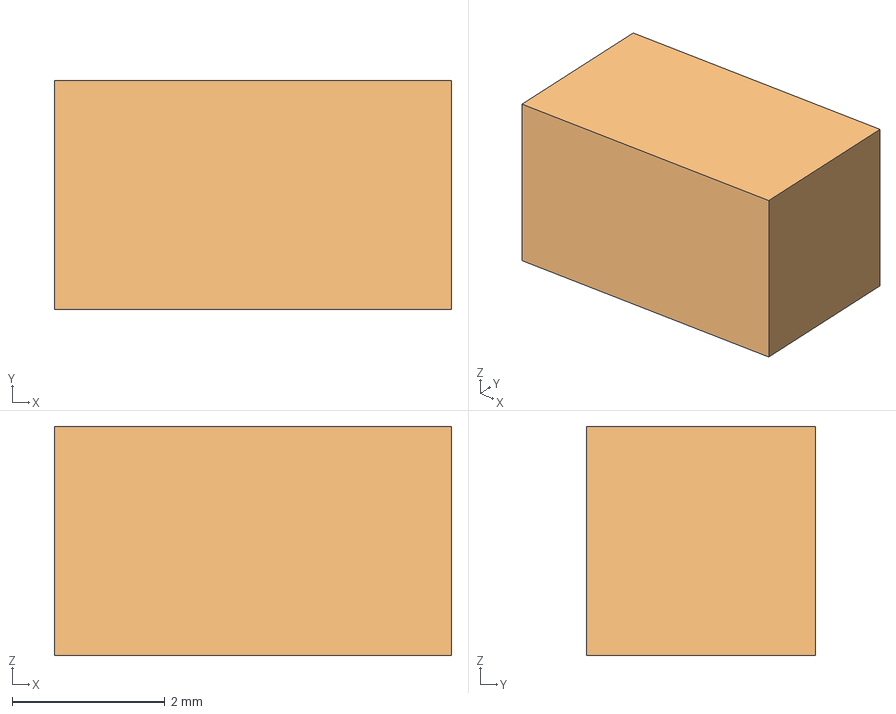
[picture p22: CAD file, 2023-05-17]
overmolding/led window cutout.FCStd
5.20 x 3.00 x 3.00 mm
led_window_cutout001
led_window_cutout001 (Solid)
led window cutout
