juniper-garden/twig_temp_humidity_sensor/temp sensor led and sensor port cutout windows.step

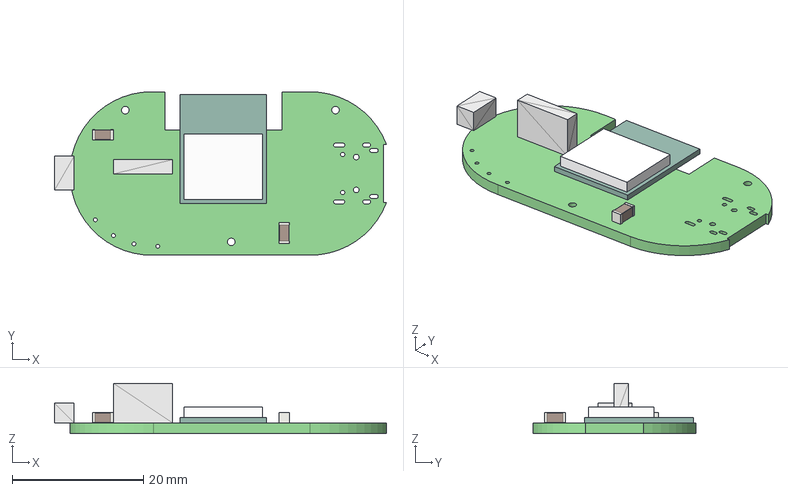
[picture p23: CAD file, 2023-05-17]
temp sensor led and sensor port cutout windows.step
50.6 x 24.9 x 7.65 mm
temp sensor PCB
