juniper-garden/twig_temp_humidity_sensor/overmolding/Unnamed-sensor_window_cutout002 (Solid).step

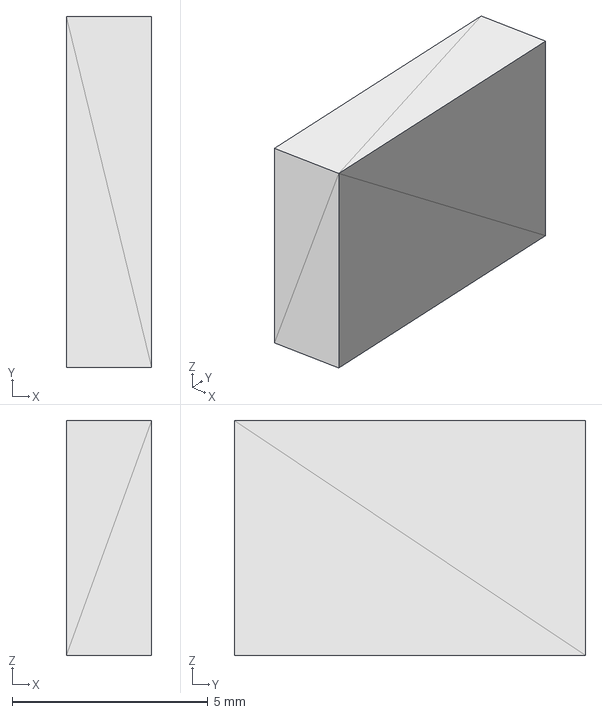
[picture p24: CAD file, 2023-05-17]
overmolding/Unnamed-sensor_window_cutout002 (Solid).step
2.18 x 8.97 x 6.00 mm
