juniper-garden/twig_temp_humidity_sensor/QLS6A-FKW-CNSNSF043--3DModel-STEP-56544.STEP

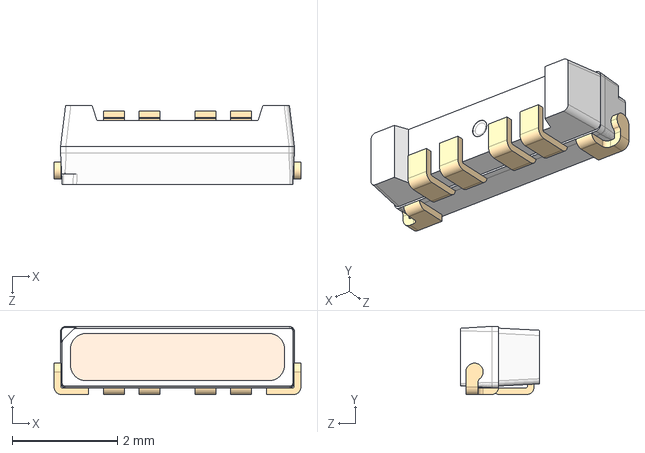
[picture p25: CAD file, 2023-05-17]
QLS6A-FKW-CNSNSF043--3DModel-STEP-56544.STEP
4.70 x 1.30 x 1.50 mm
