juniper-garden/twig_temp_humidity_sensor/temp sensorv3.step

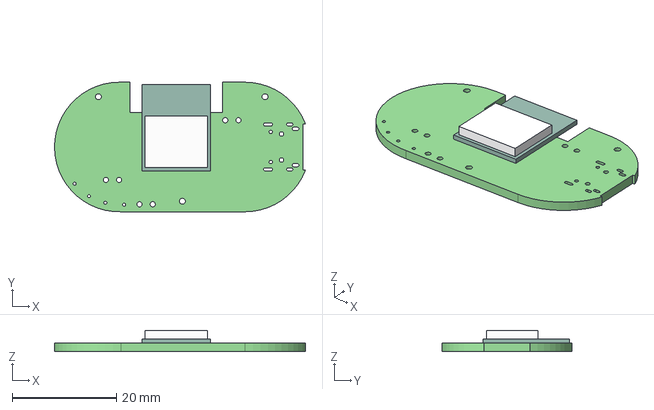
[picture p26: CAD file, 2023-05-17]
temp sensorv3.step
48.2 x 24.9 x 4.05 mm
temp sensor PCB
