juniper-garden/twig_temp_humidity_sensor/USB4105-GF-A--3DModel-STEP-56544.STEP

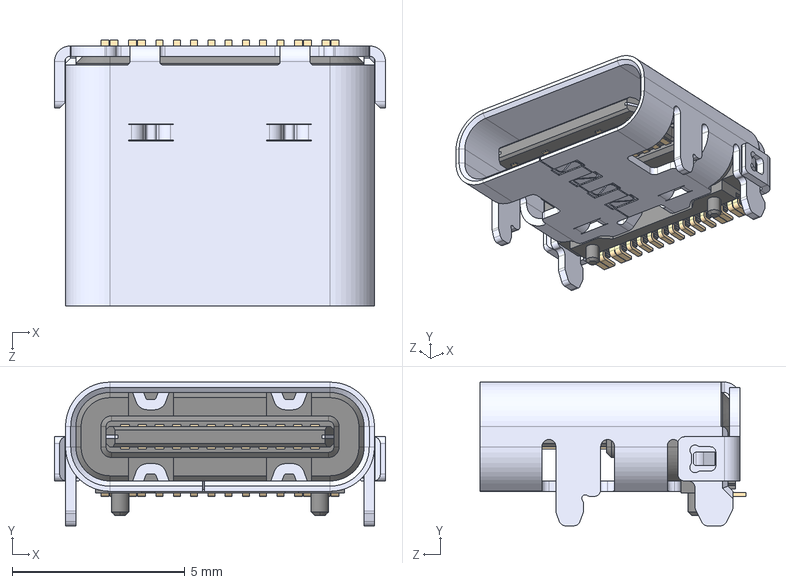
[picture p27: CAD file, 2023-05-17]
USB4105-GF-A--3DModel-STEP-56544.STEP
9.58 x 4.16 x 7.71 mm
