juniper-garden/twig_temp_humidity_sensor/AS7341-DLGT.step

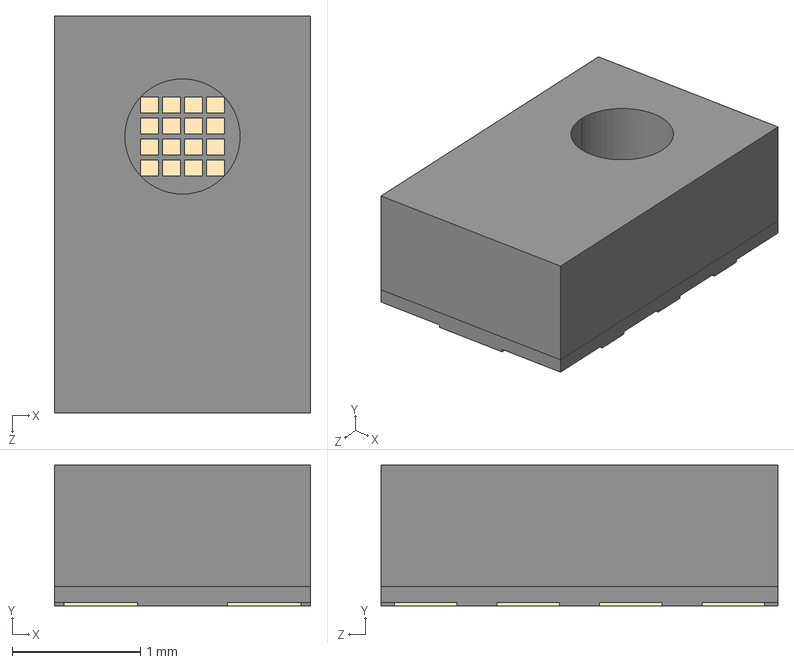
[picture p28: CAD file, 2023-05-17]
AS7341-DLGT.step
2.00 x 1.10 x 3.10 mm
