juniper-garden/twig_temp_humidity_sensor/overmolding/sensor window cutout.scad

color("gray") cube([2.18,8.97,6], center = false);
  
