juniper-garden/twig_temp_humidity_sensor/overmolding/led window cutout.scad

color("gray") cube([5.2,3,3], center = false);
  
