juniper-garden/twig_temp_humidity_sensor/(list of files, cad)

Other CAD files:
overmolding/led window cutout.stl
overmolding/sensor window cutout.stl
