juniper-garden/twig_temp_humidity_sensor/schematic/temp sensor 0v3.pdf

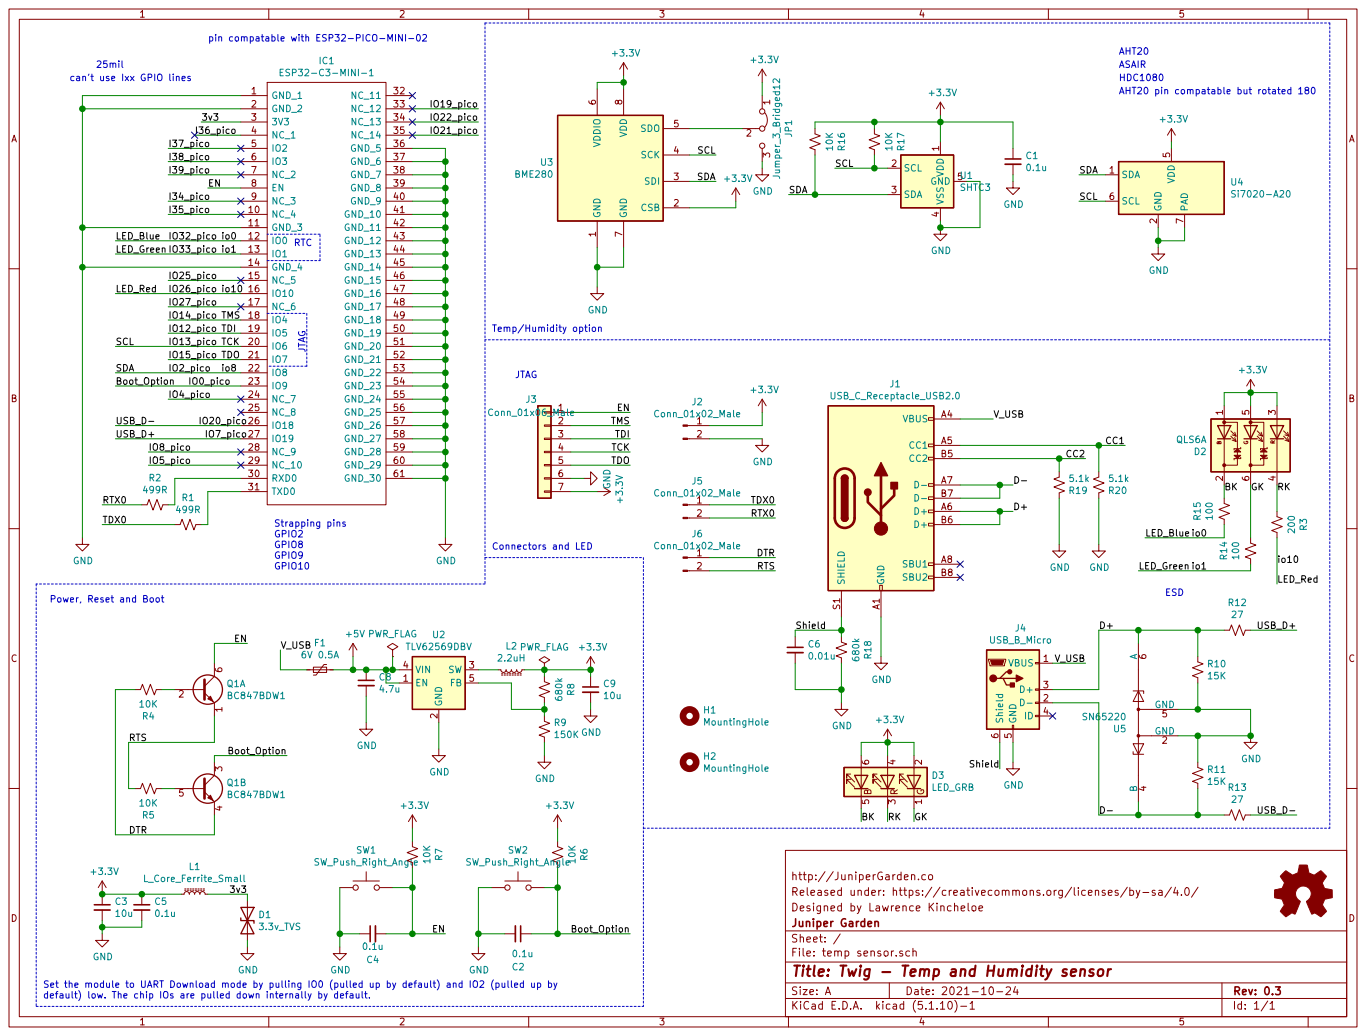
[picture p29: page 1]

pin compatable with ESP32-PICO-MINI-02

25mil
can't use Ixx GPIO lines

AHT20 pin compatable but rotated 180 RTC

1 CSB 2 SDI 3 SCK 4 SDO 5 VDDIO

2 SW 3 VIN 4 FB 5 U2 TLV62569DBV GND

Released under: https://creativecommons.org/licenses/by-sa/4.0/
Designed by Lawrence Kincheloe
File: temp sensor.sch Sheet: / Juniper Garden

Id: 1/1 Title: Twig - Temp and Humidity sensor

Set the module to UART Download mode by pulling IO0 (pulled up by default) and IO2 (pulled up by
