juniper-garden/twig_temp_humidity_sensor/overmolding/overmolding suggestions.pdf

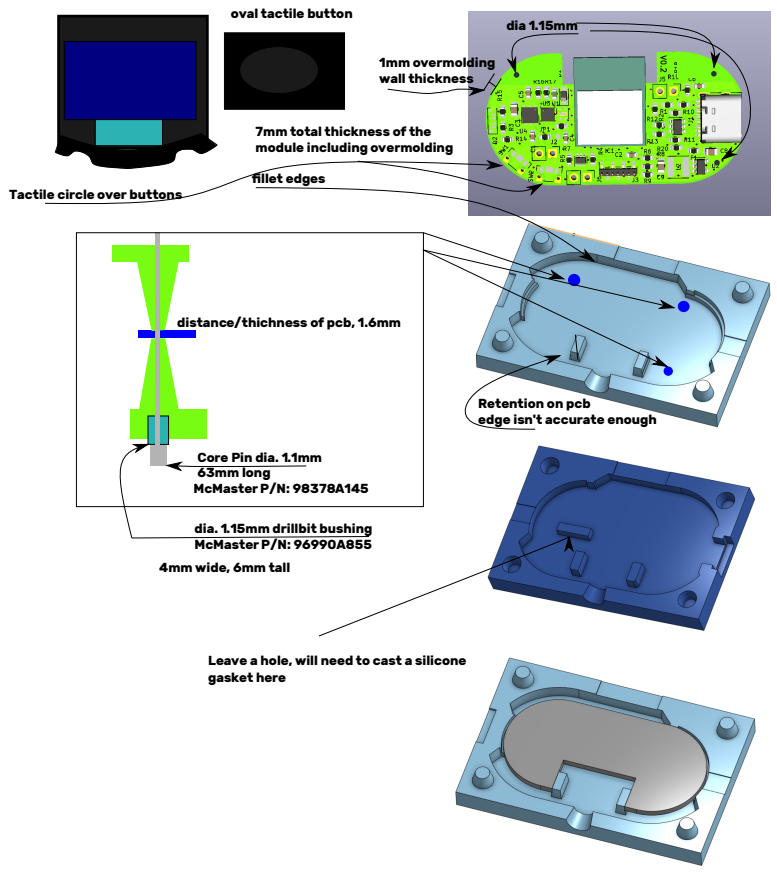
[picture p30: page 1]
dia 1.15mm; fillet edges; 1mm overmolding wall thickness

oval tactile button

7mm total thickness of the
module including overmolding

Tactile circle over buttons

distance/thichness of pcb, 1.6mm

Retention on pcb
edge isn't accurate enough

Core Pin dia. 1.1mm
63mm long
McMaster P/N: 98378A145

dia. 1.15mm drillbit bushing
McMaster P/N: 96990A855
4mm wide, 6mm tall

Leave a hole, will need to cast a silicone
gasket here
