juniper-garden/twig_temp_humidity_sensor/PDF/temp sensor 0v1.pdf

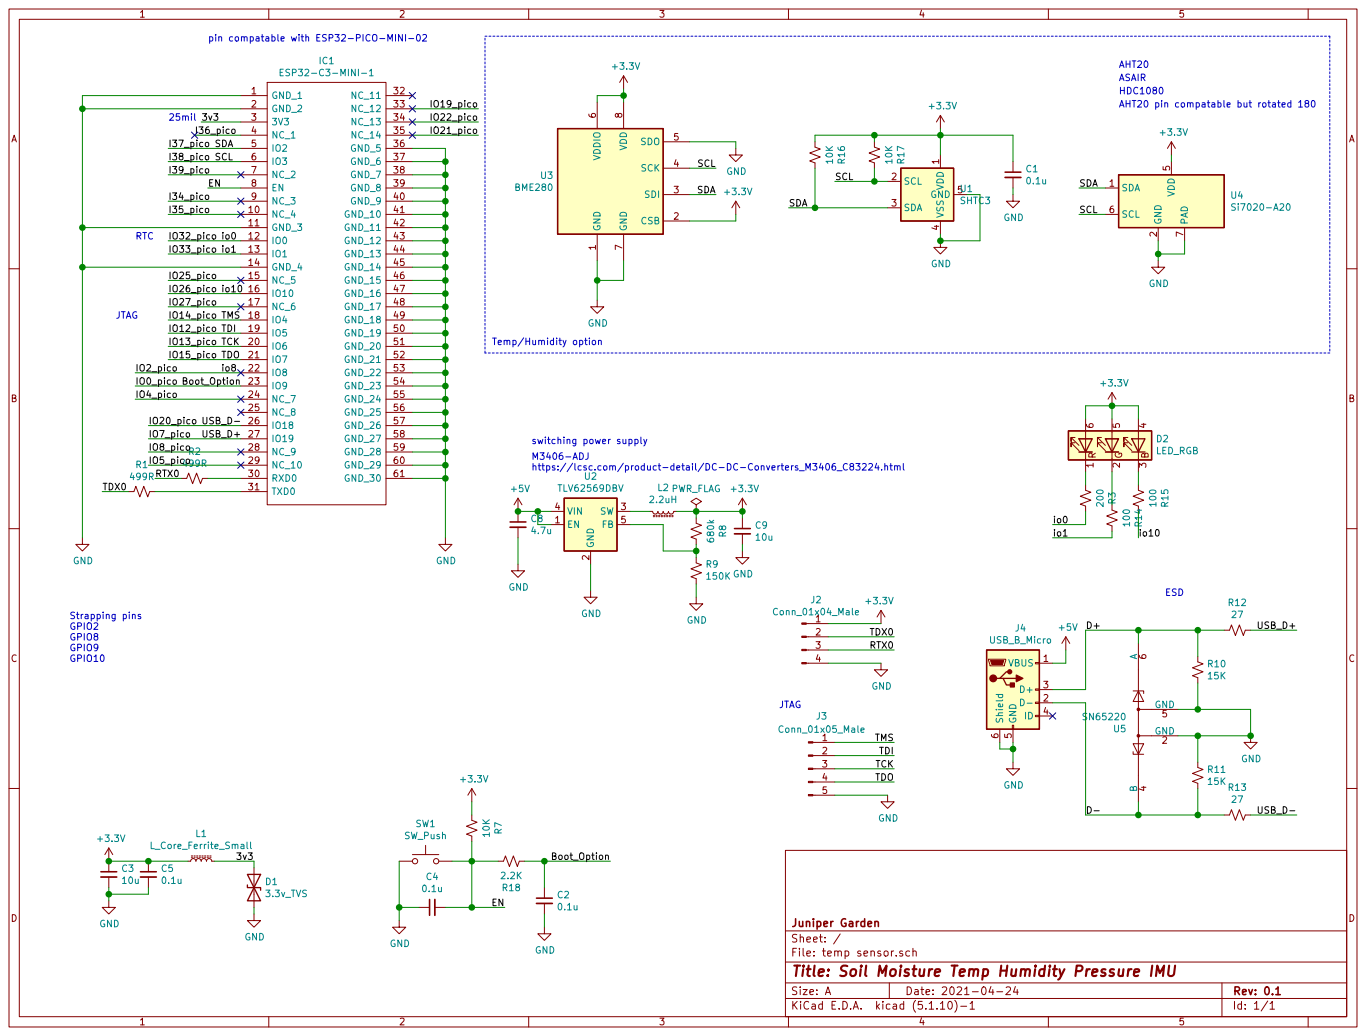
[picture p31: page 1]

LTC3109 Set the module to UART Download mode by pulling IO0 (pulled up by default) and IO2 (pulled down by

1 CSB 2 SDI 3 SCK 4 SDO 5 VDDIO

2 SW 3 VIN 4 FB 5 U2 TLV62569DBV GND

Id: 1/1 Title: Soil Moisture Temp Humidity Pressure IMU
