juniper-garden/twig_temp_humidity_sensor/PDF/temp sensor-Dwgs_User.pdf

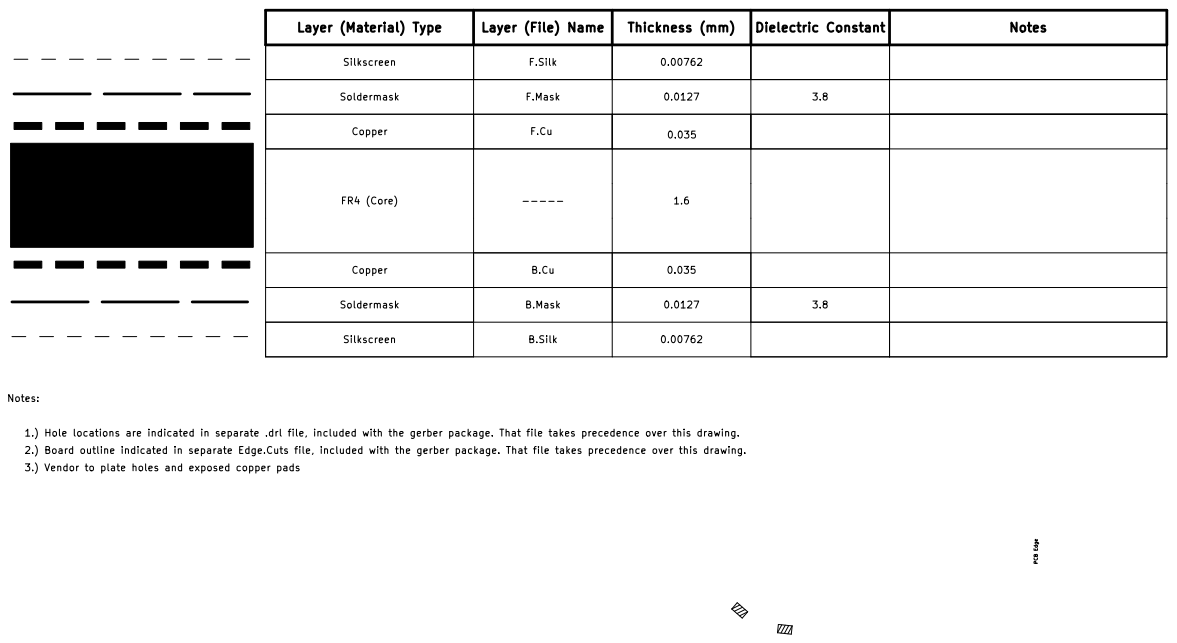
[picture p32: page 1]

Layer (File) Name | Thickness (mm) 0.00762 Layer (Material) Type | Dielectric Constant | Notes

Silkscreen | F.Silk | 0.00762 F.Mask

F.Cu | 0.0127 Copper 0.035 Soldermask

FR4 (Core) Copper Soldermask Silkscreen | B.Cu B.Mask B.Silk ----- | 1.6

Notes: 1.) Hole locations are indicated in separate .drl file, included with the gerber package. That file takes precedence over this drawing. 2.) Board outline indicated in separate Edge.Cuts file, included with the gerber package. That file takes precedence over this drawing. 3.) Vendor to plate holes and exposed copper pads
