juniper-garden/twig_temp_humidity_sensor/PDF/temp sensor-User_Drawings.pdf

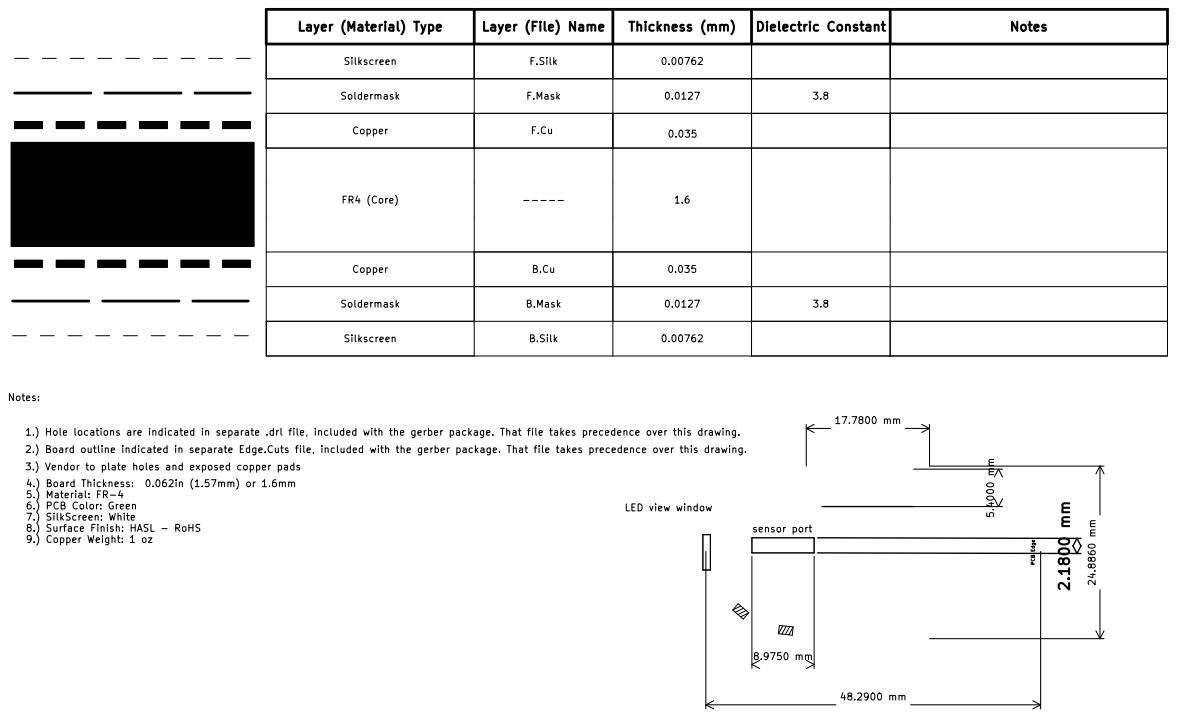
[picture p33: page 1]

1.6 F.Silk Layer (Material) Type

0.035 Layer (File) Name 0.0127 Silkscreen | 3.8 Thickness (mm) | Notes

1.) Hole locations are indicated in separate .drl file, included with the gerber package. That file takes precedence over this drawing. Copper Soldermask

B.Silk B.Cu Silkscreen Copper

4.) Board Thickness: 0.062in (1.57mm) or 1.6mm
5.) Material: FR-4
6.) PCB Color: Green
7.) SilkScreen: White
8.) Surface Finish: HASL - RoHS
