juniper-garden/twig_temp_humidity_sensor/drill print sheet.pdf

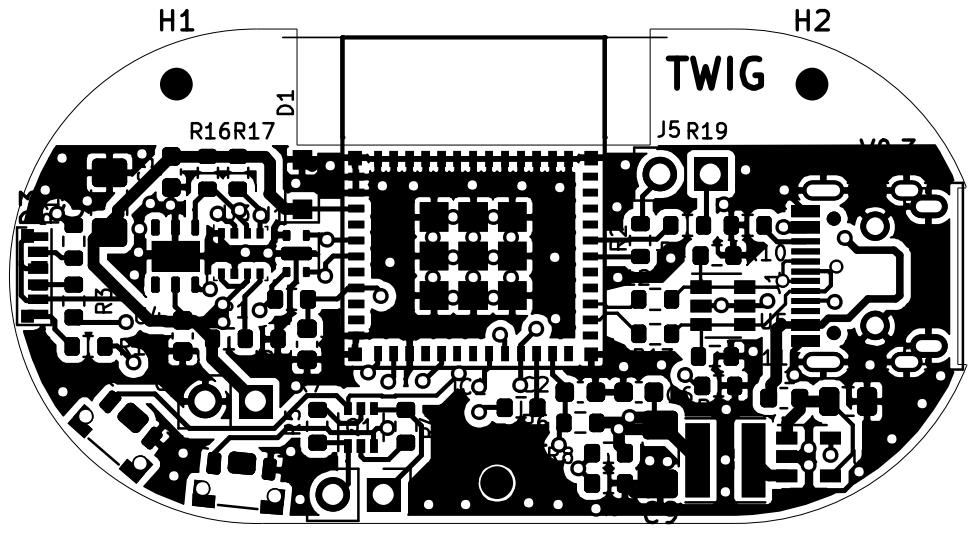
[picture p34: page 1]
