juniper-garden/twig_temp_humidity_sensor/PDF/Part Placement 0.2v.pdf

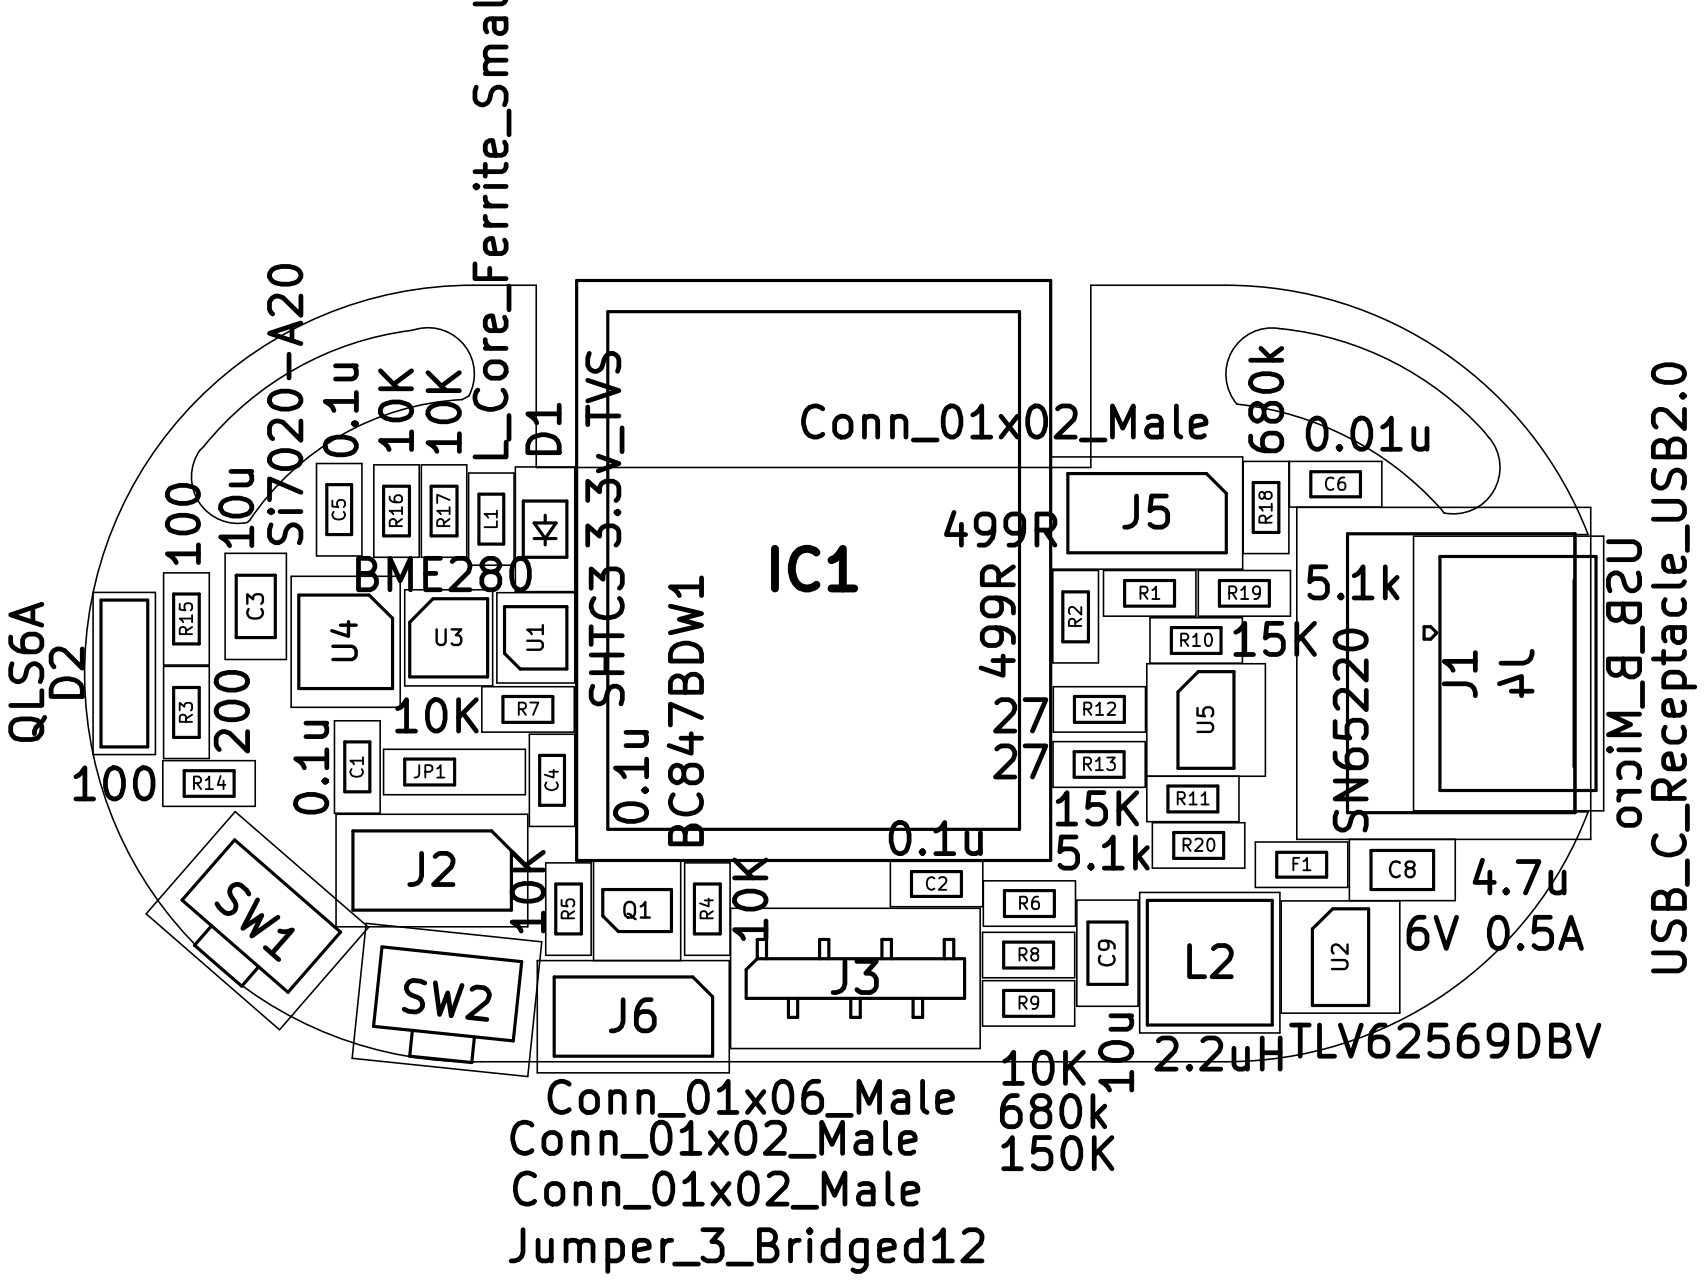
[picture p35: page 1]
