juniper-garden/twig_temp_humidity_sensor/PDF/Part Placement 0.3v.pdf

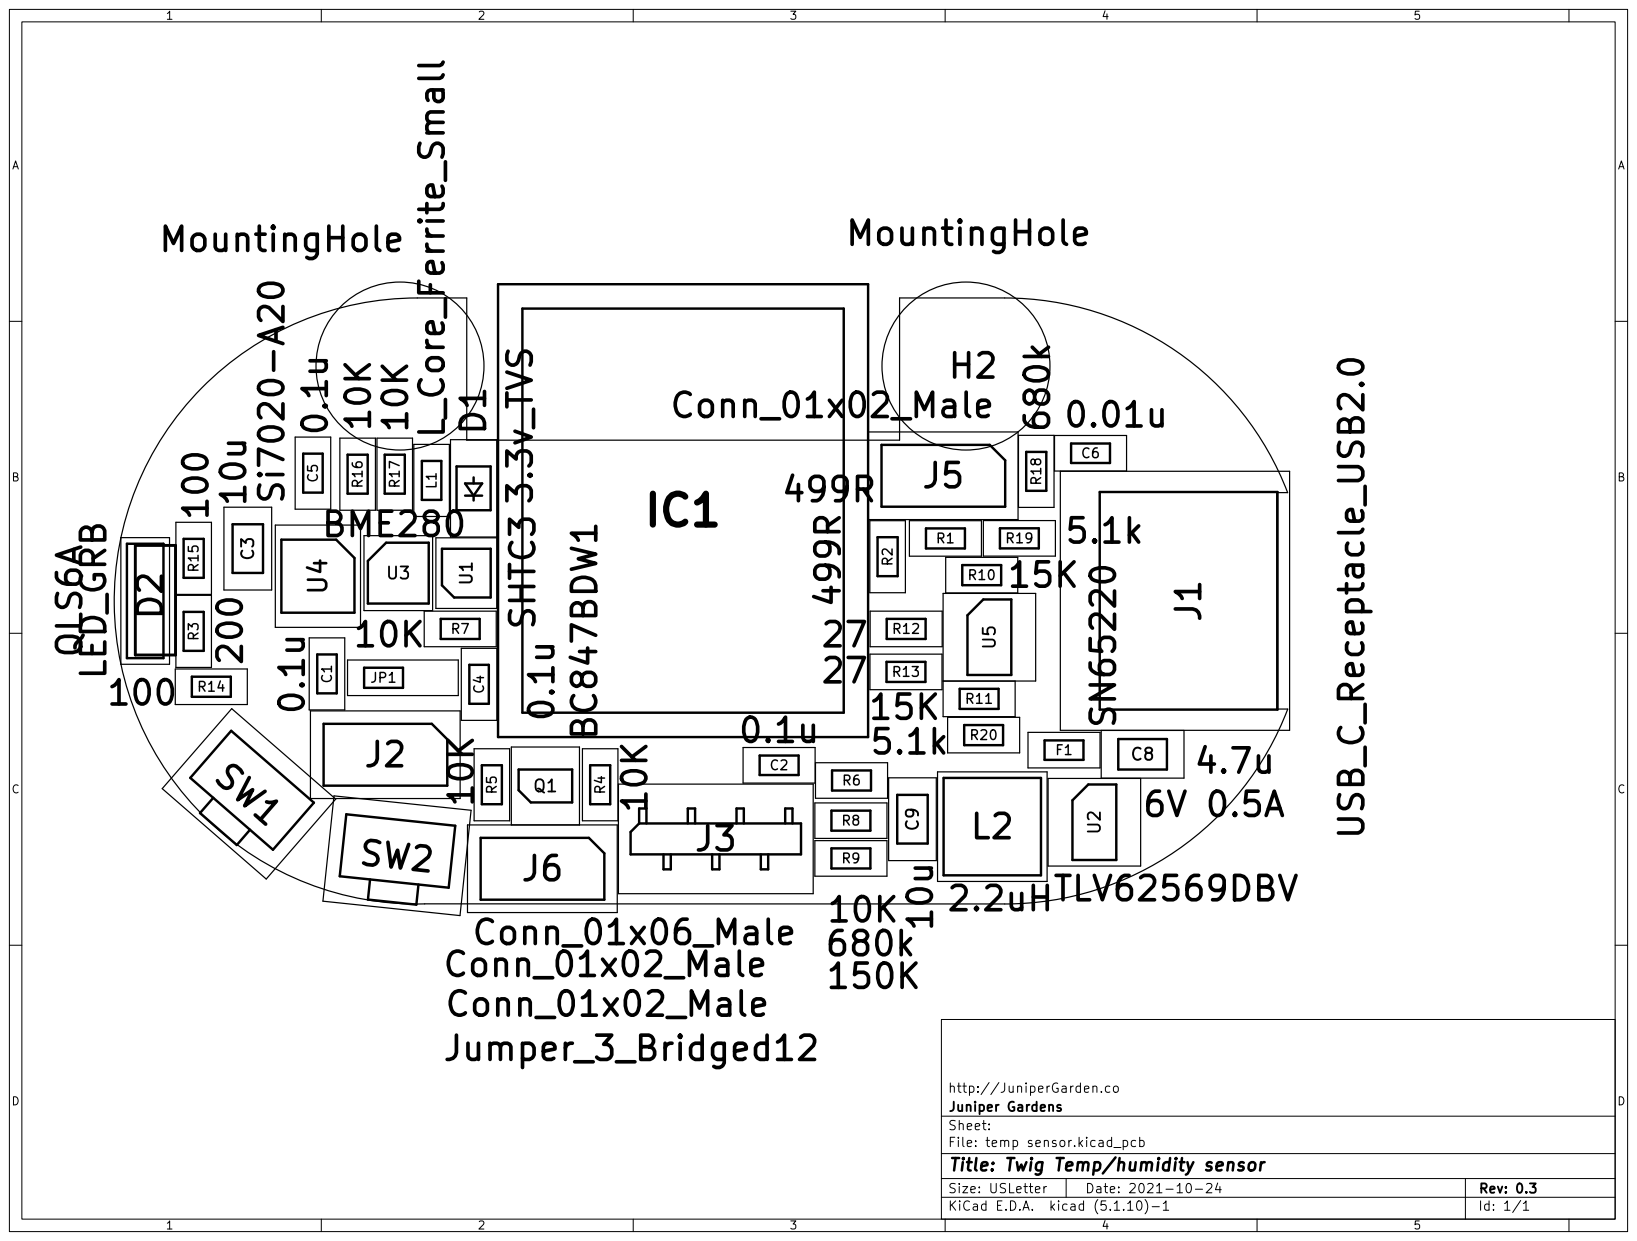
[picture p36: page 1]
