juniper-garden/twig_temp_humidity_sensor/PDF/temp sensor-B_Courtyard.pdf

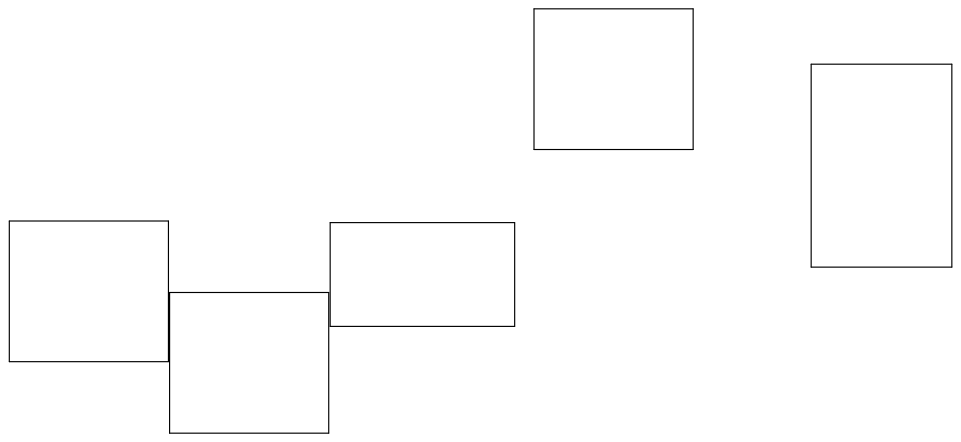
[picture p37: page 1]
