juniper-garden/twig_temp_humidity_sensor/PDF/temp sensor-B_Cu.pdf

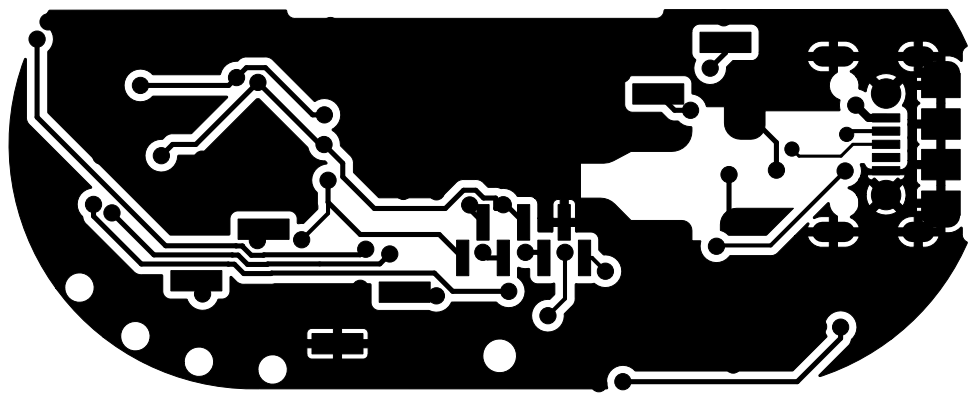
[picture p38: page 1]
