juniper-garden/twig_temp_humidity_sensor/PDF/temp sensor-B_Fab.pdf

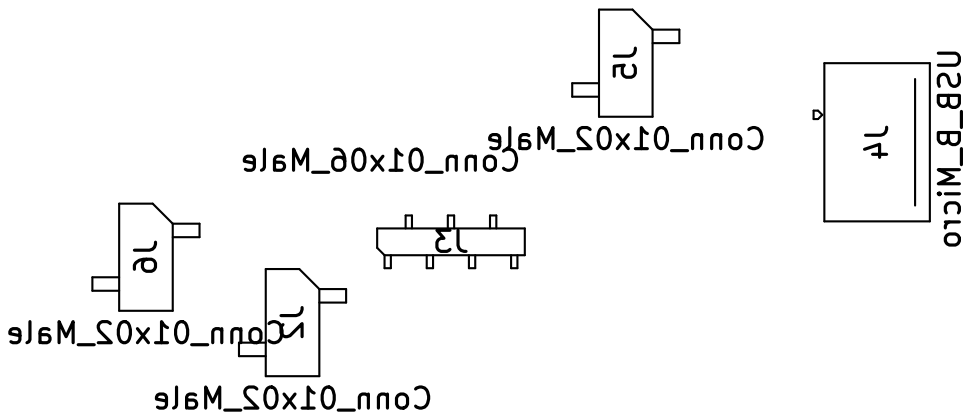
[picture p39: page 1]
