juniper-garden/twig_temp_humidity_sensor/PDF/temp sensor-B_Mask.pdf

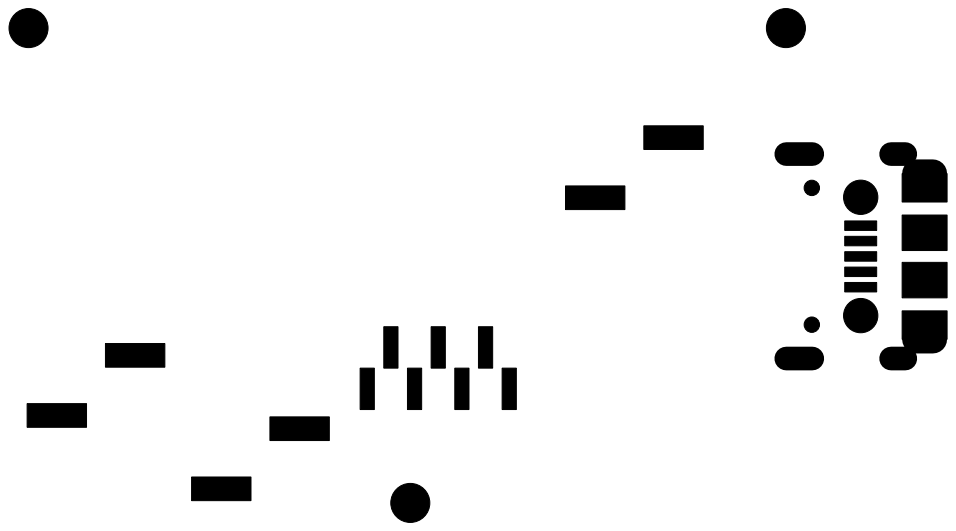
[picture p40: page 1]
