juniper-garden/twig_temp_humidity_sensor/PDF/temp sensor-B_Paste.pdf

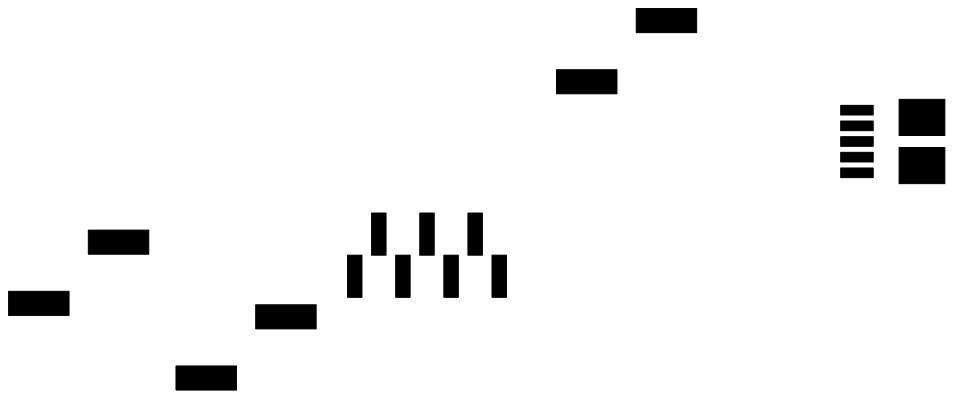
[picture p41: page 1]
