juniper-garden/twig_temp_humidity_sensor/PDF/temp sensor-B_SilkS.pdf

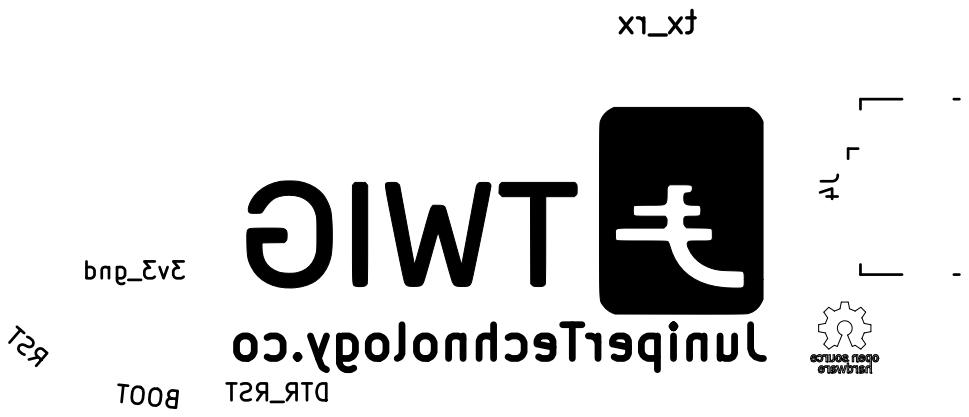
[picture p42: page 1]
