juniper-garden/twig_temp_humidity_sensor/PDF/temp sensor-B_Silkscreen.pdf

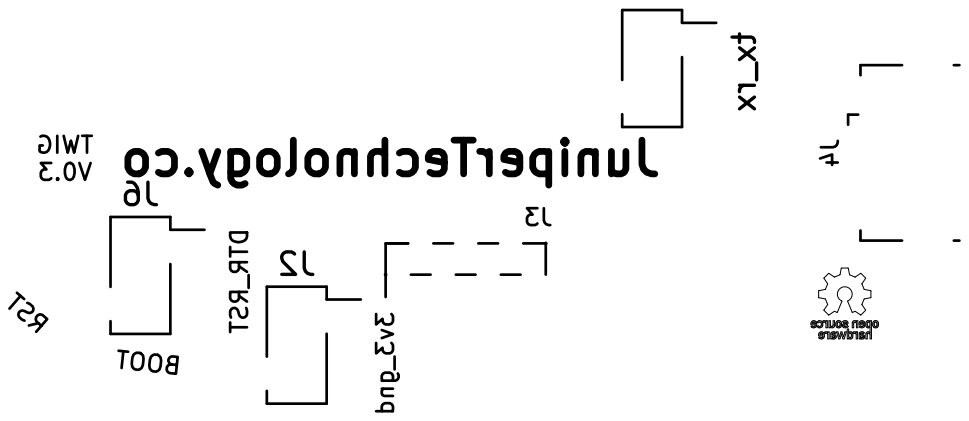
[picture p43: page 1]
