juniper-garden/twig_temp_humidity_sensor/PDF/temp sensor-Edge_Cuts.pdf

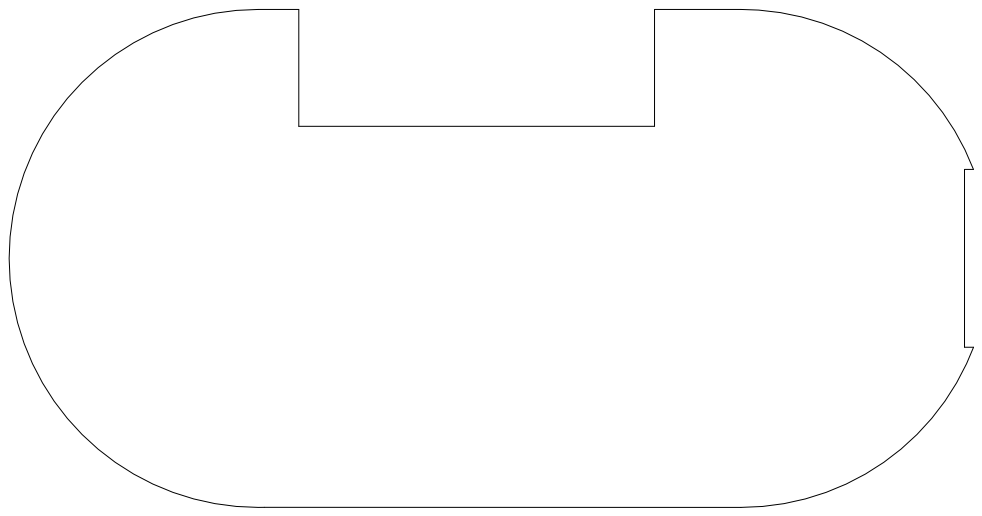
[picture p44: page 1]
