juniper-garden/twig_temp_humidity_sensor/PDF/temp sensor-F_Courtyard.pdf

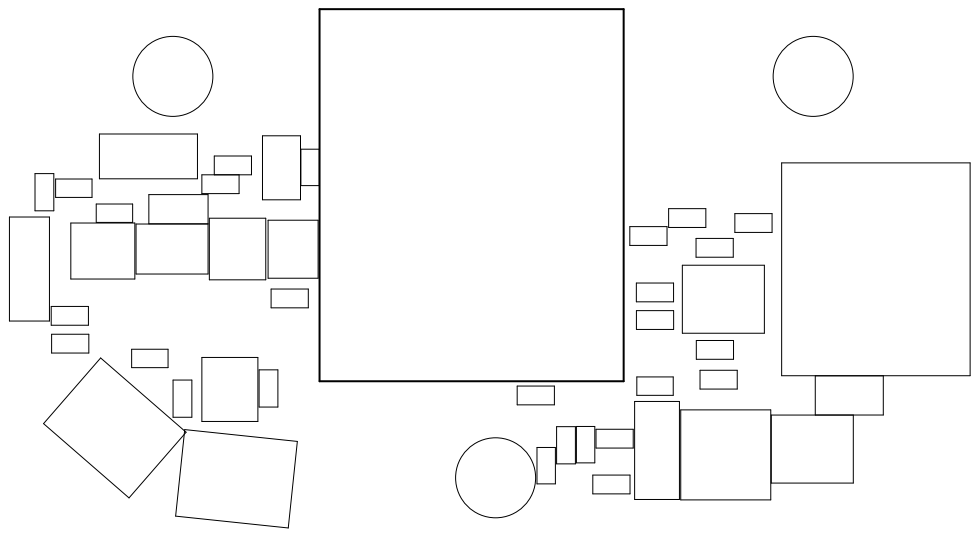
[picture p45: page 1]
