juniper-garden/twig_temp_humidity_sensor/PDF/temp sensor-F_Cu.pdf

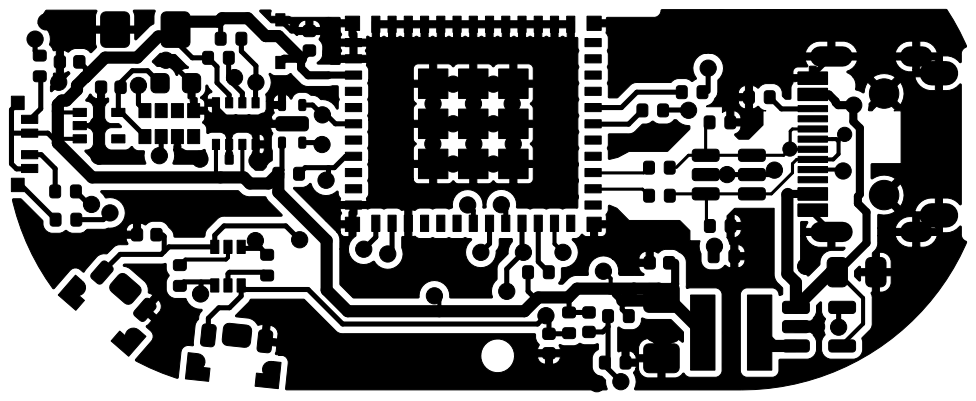
[picture p46: page 1]
