juniper-garden/twig_temp_humidity_sensor/PDF/temp sensor-F_Fab.pdf

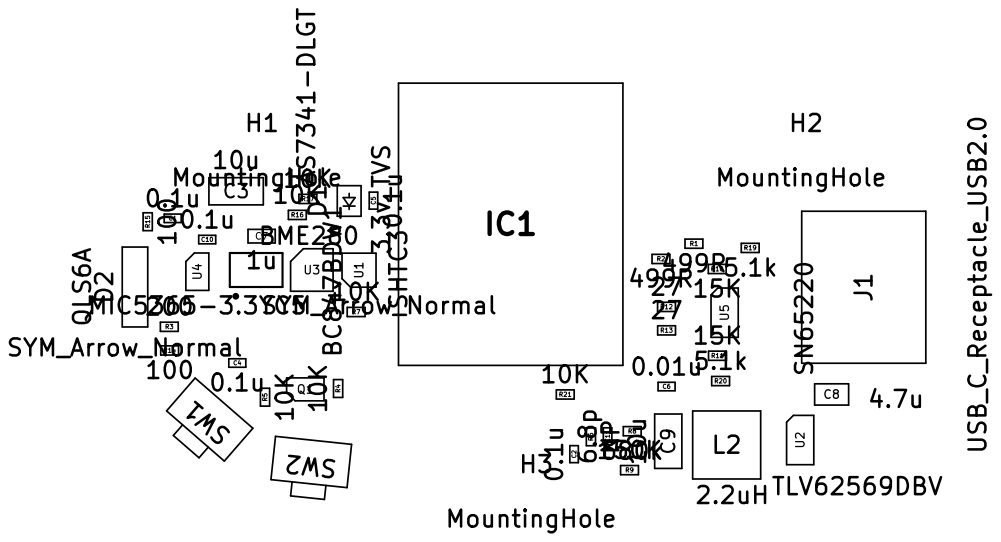
[picture p47: page 1]
