juniper-garden/twig_temp_humidity_sensor/PDF/temp sensor-F_Mask.pdf

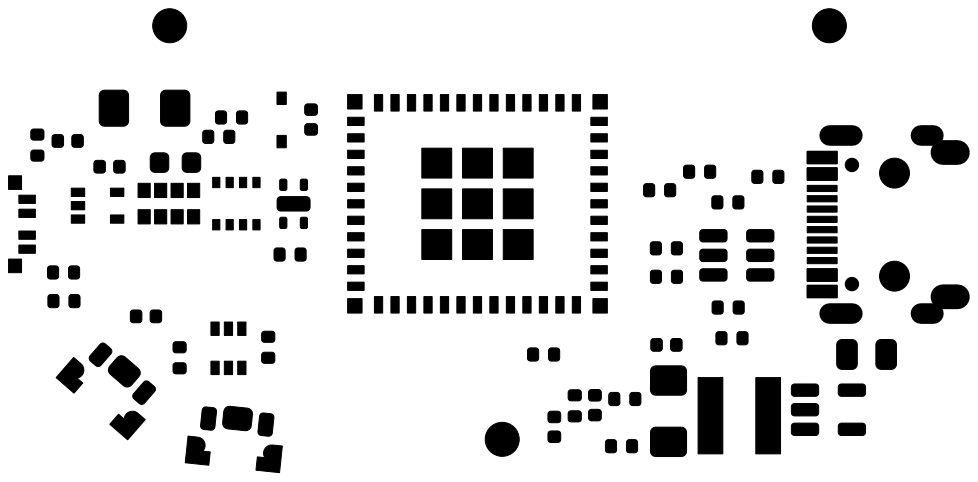
[picture p48: page 1]
