juniper-garden/twig_temp_humidity_sensor/PDF/temp sensor-F_Paste.pdf

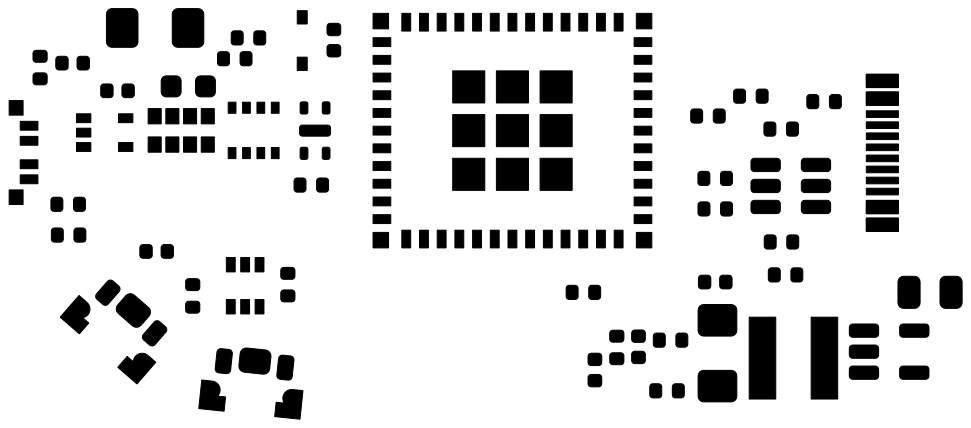
[picture p49: page 1]
