juniper-garden/twig_temp_humidity_sensor/PDF/temp sensor-F_SilkS.pdf

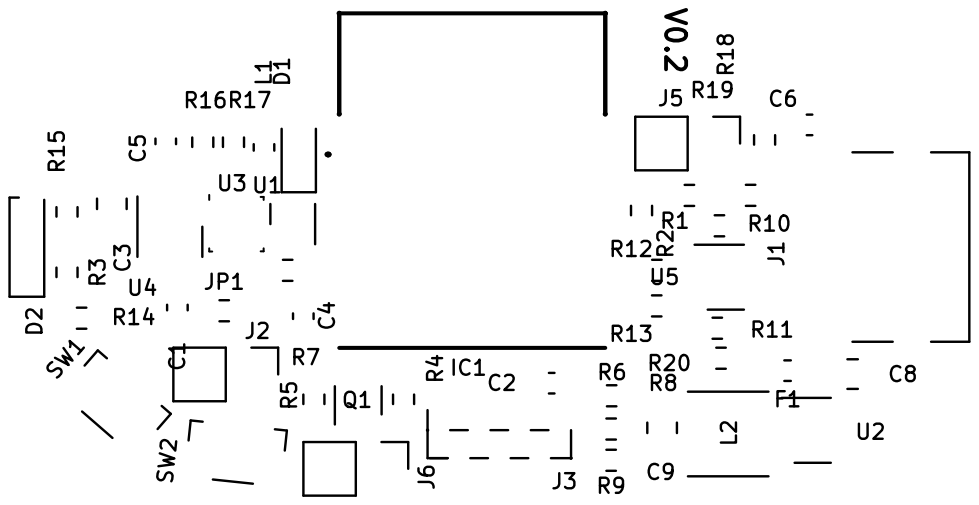
[picture p50: page 1]
