juniper-garden/twig_temp_humidity_sensor/PDF/temp sensor-F_Silkscreen.pdf

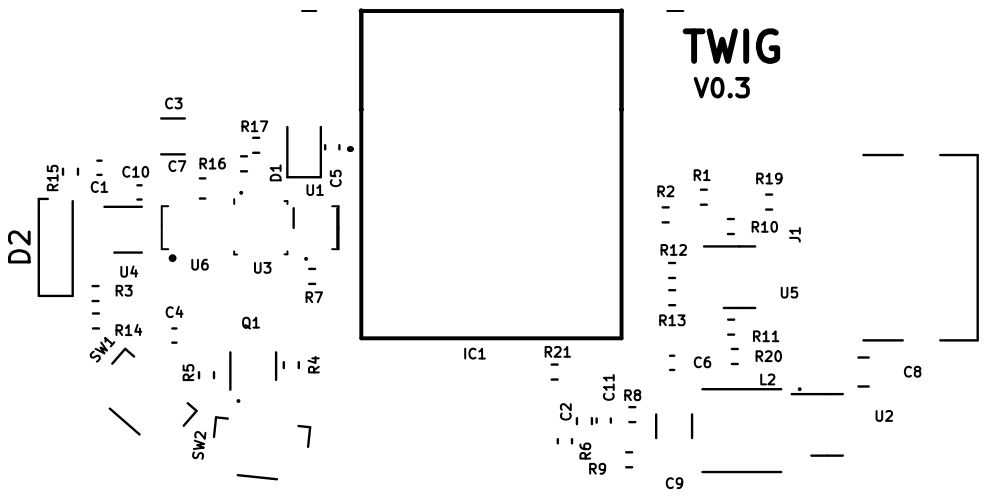
[picture p51: page 1]
