juniper-garden/twig_temp_humidity_sensor/temp sensor.kicad_pcb

## KiCad design temp sensor.kicad_pcb (2023-05-17)

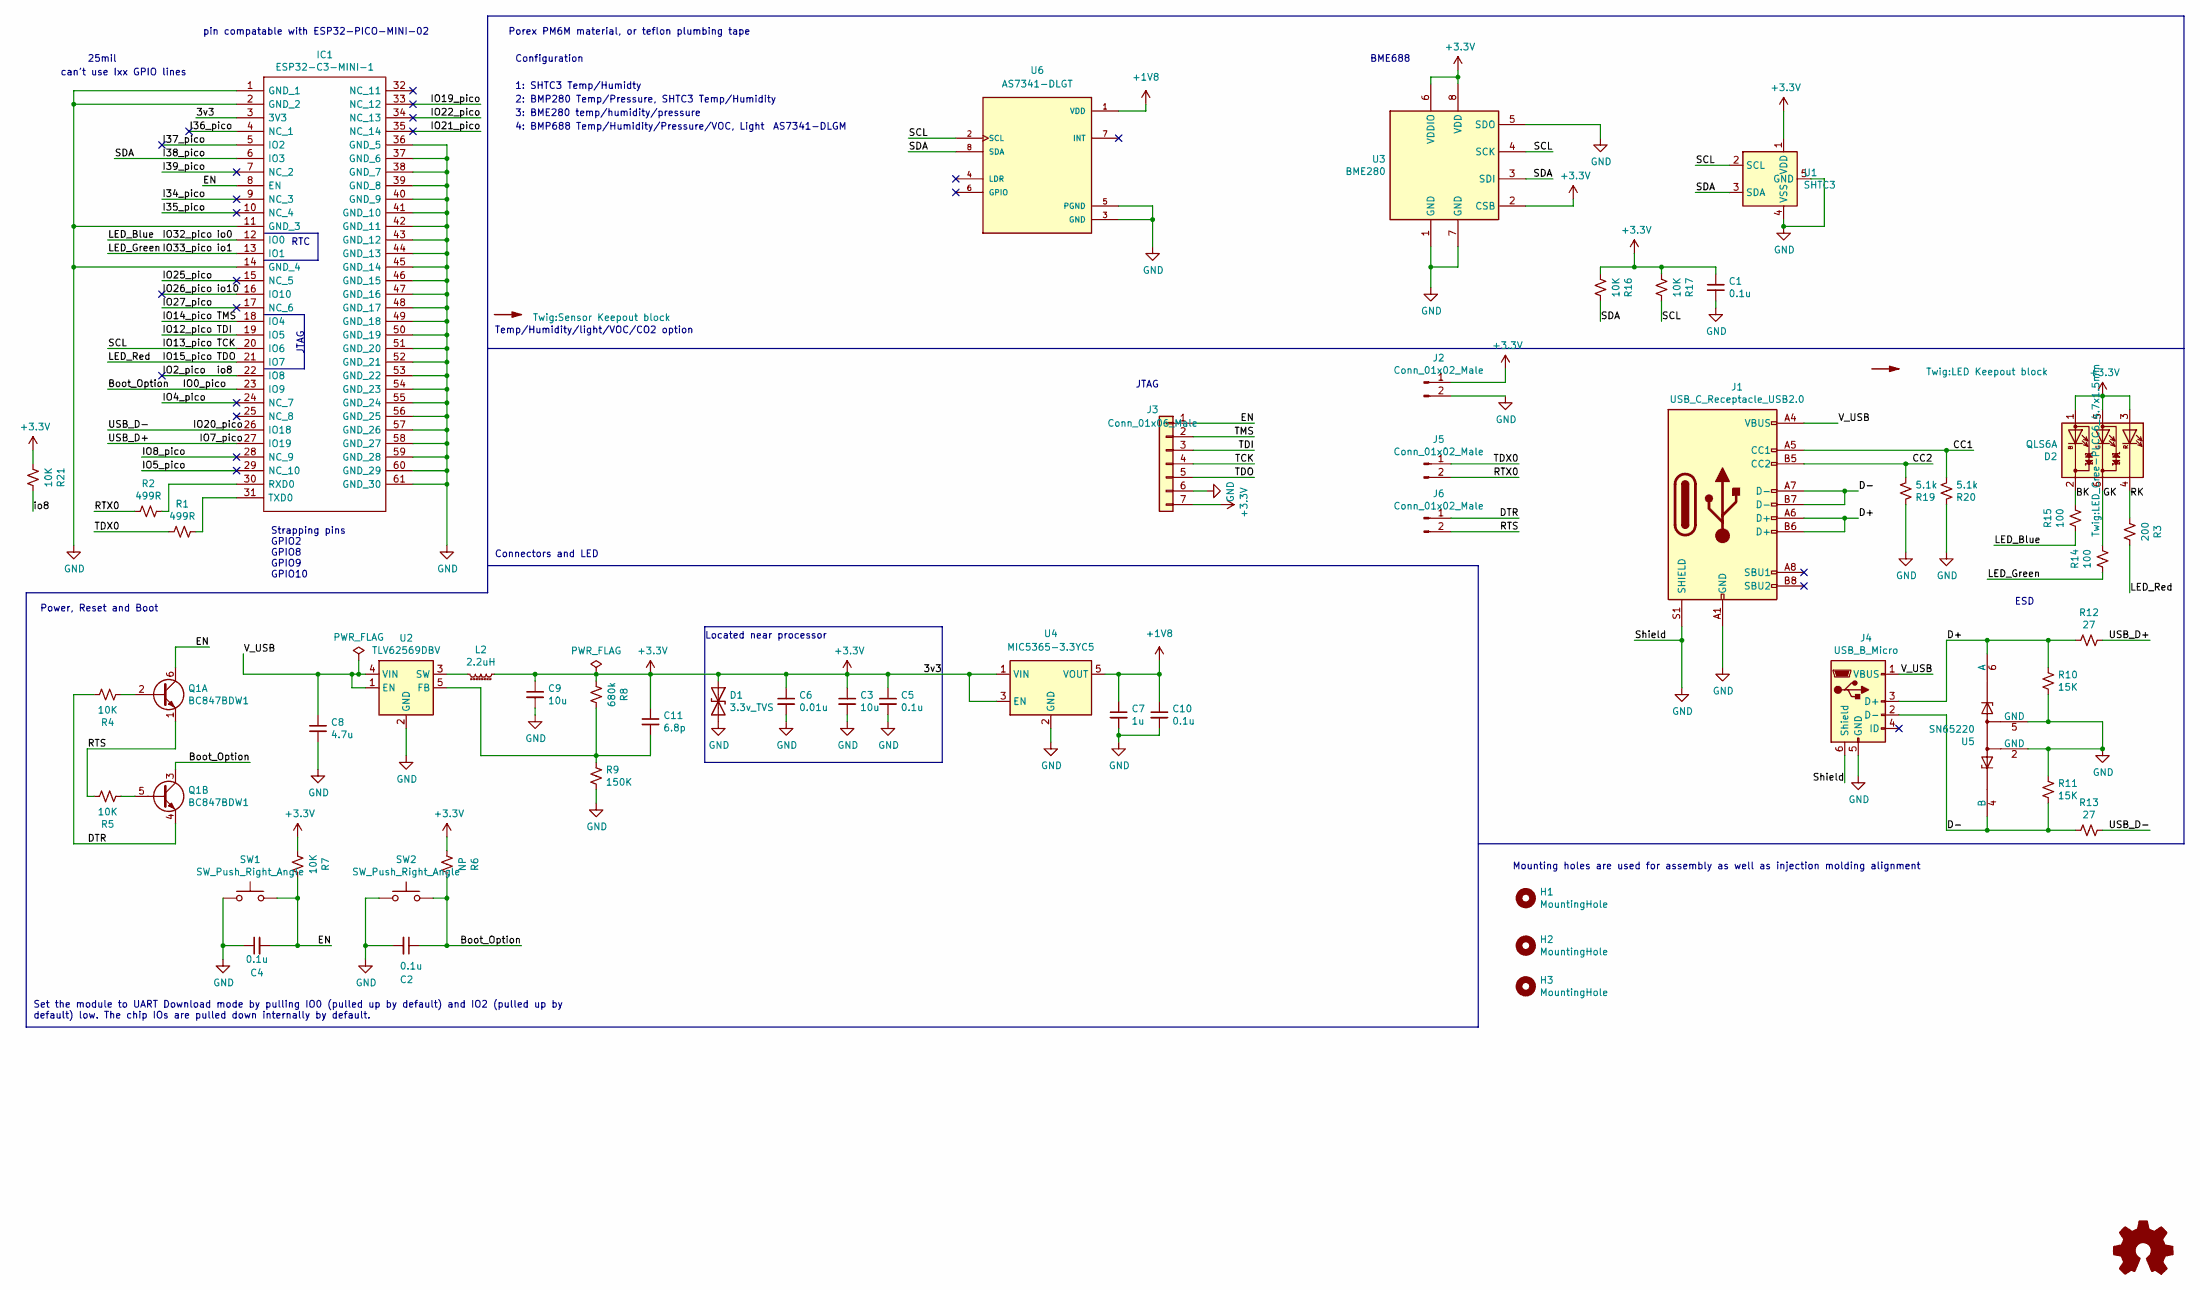
[picture p52: schematic temp sensor.kicad_sch, Twig - Temp and Humidity sensor]

Parts:
C1, C2, C4, C5, C10: 0.1u; C_0402_1005Metric; Manufacturer_Part_Number EMK105B7104KVHF; Mouser Part Number 963-EMK105B7104KVHF
C3, C9: 10u; C_1206_3216Metric_Pad1.42x1.75mm_HandSolder; Manufacturer_Part_Number LMK212ABJ106MG-T; Mouser Part Number 963-LMK212ABJ106MG-T
C6: 0.01u; C_0402_1005Metric; Manufacturer_Part_Number EMK105B7103KVHF; Mouser Part Number 963-EMK105B7103KVHF
C7: 1u; C_0603_1608Metric; Manufacturer_Part_Number EMK107B7105KA-T; Mouser Part Number 963-EMK107B7105KA-T
C8: 4.7u; C_0805_2012Metric; Manufacturer_Part_Number JMK107C6475KA-T; Mouser Part Number 963-JMK107C6475KA-T
C11: 6.8p; C_0402_1005Metric; Manufacturer_Part_Number EMK105B7103KVHF; Mouser Part Number 963-EMK105B7103KVHF
D1: 3.3v_TVS; D_SOD-323; Manufacturer_Part_Number SD03C-7; Mouser Part Number 621-SD03C-7
D2: QLS6A; LED_Cree-PLCC6_4.7x1.5mm; Manufacturer_Part_Number QLS6A-FKW-CNSNSF043; Mouser Part Number 941-QLS6AFKWNSNSF043
H1, H2, H3: MountingHole; CorePin_1.15mm; PARTREV V3
IC1: ESP32-C3-MINI-1; ESP32C3MINI1; Manufacturer_Part_Number ESP32-C3-MINI-1-H4; Mouser Part Number 356-ESP32-C3-MINI1H4
J1: USB_C_Receptacle_USB2.0; USB_C_Receptacle_HRO_TYPE-C-31-M-12; Manufacturer_Part_Number USB4105-GF-A; Mouser Part Number 640-USB4105-GF-A
J2, J5, J6: Conn_01x02_Male; PinHeader_1x02_P2.54mm_Vertical_SMD_Pin1Left
J3: Conn_01x06_Male; PinHeader_1x07_P1.00mm_Vertical_SMD_Pin1Right
J4: USB_B_Micro; USB_Micro-B_Molex-105017-0001; Manufacturer_Part_Number 105017-0001; Mouser Part Number 538-105017-0001
L2: 2.2uH; L_Taiyo-Yuden_MD-4040; Manufacturer_Part_Number MDMK4040T2R2MM; Mouser Part Number 963-MDMK4040T2R2MM
LOGO1: Logo_Open_Hardware_Small; FabDrawing-2Layer-Metric
Q1: BC847BDW1; SOT-363_SC-70-6; Manufacturer_Part_Number BC847BDW1T1G; Mouser Part Number 863-BC847BDW1T1G
R1, R2: 499R; R_0402_1005Metric; Manufacturer_Part_Number CR0603-FX-4990ELF; Mouser Part Number 652-CR0603FX-4990ELF
R3: 200; R_0402_1005Metric; Manufacturer_Part_Number CR0603-FX-2000ELF; Mouser Part Number 652-CR0603-FX2000ELF
R4, R5, R7, R16, R17, R21: 10K; R_0402_1005Metric; Manufacturer_Part_Number ESR03EZPJ103; Mouser Part Number 755-ESR03EZPJ103
R6: NP; R_0402_1005Metric; Manufacturer_Part_Number ESR03EZPJ103; Mouser Part Number 755-ESR03EZPJ103
R8: 680k; R_0402_1005Metric; Manufacturer_Part_Number RC0603FR-13680KL; Mouser Part Number 603-RC0603FR-13680KL
R9: 150K; R_0402_1005Metric; Manufacturer_Part_Number RC0603FR-07150KL; Mouser Part Number 603-RC0603FR-07150KL
R10, R11: 15K; R_0402_1005Metric; Manufacturer_Part_Number RC0603FR-1315KL; Mouser Part Number 603-RC0603FR-1315KL
R12, R13: 27; R_0402_1005Metric; Manufacturer_Part_Number RK73B1JTTDD270J; Mouser Part Number 660-RK73B1JTTDD270J
R14, R15: 100; R_0402_1005Metric; Manufacturer_Part_Number RC0603JR-07100RL; Mouser Part Number 603-RC0603JR-07100RL
R19, R20: 5.1k; R_0402_1005Metric; Manufacturer_Part_Number CR0603-FX-5101ELF; Mouser Part Number 652-CR0603FX-5101ELF
SW1, SW2: SW_Push_Right_Angle; SW_Push_1P1T-MP_NO_Horizontal_TL6340; Manufacturer_Part_Number TL6340AF160QG; Mouser Price/Stock $0.48/10000
SYM1: SYM_Arrow_Normal; Sensor Keepout block
SYM2: SYM_Arrow_Normal; LED Keepout block
U1: SHTC3; Sensirion_DFN-4-1EP_2x2mm_P1mm_EP0.7x1.6mm; Manufacturer_Part_Number SHTC3; Mouser Part Number 403-SHTC3
U2: TLV62569DBV; SOT-23-5; Manufacturer_Part_Number TLV62569DBVR; Mouser Part Number 595-TLV62569DBVR
U3: BME280; Bosch_LGA-8_2.5x2.5mm_P0.65mm_ClockwisePinNumbering; Manufacturer_Part_Number BME280; Mouser Part Number 262-BME280
U4: MIC5365-3.3YC5; SOT-353_SC-70-5
U5: SN65220; SOT-23-6; Manufacturer_Part_Number SN65220DBVT; Mouser Part Number 595-SN65220DBVT
U6: AS7341-DLGT; PSON80P310X200X110-8N; PARTREV V3

Connections:
+1V8: C7.1, C10.1, U4.5 (VOUT), U6.1 (VDD)
+3V3: C1.1, C3.1, C5.1, C6.1, C9.1, C11.1, D1.1 (A1), D2.1 (AB), D2.3 (AR), D2.5 (AG), IC1.3 (3V3), J2.1, J3.7, L2.2, R6.2, R7.2, R8.2, R16.2, R17.2, R21.2, U1.1 (VDD), U3.2 (CSB), U3.6 (VDDIO), U3.8 (VDD), U4.1 (VIN), U4.3 (EN)
/BK: D2.2 (KB), R15.1
/Boot_Option: C2.1, IC1.23 (IO9), Q1.3 (C2), R6.1, SW2.2
/CC1: J1.A5 (CC1), R20.2
/CC2: J1.B5 (CC2), R19.2
/D+: J1.A6 (D+), J1.B6 (D+), J4.3 (D+), R10.1, R12.1, U5.1, U5.6 (A)
/D-: J1.A7 (D-), J1.B7 (D-), J4.2 (D-), R11.2, R13.1, U5.3, U5.4 (B)
/DTR: J6.1, Q1.4 (E2), R4.1
/EN: C4.2, IC1.8 (EN), J3.1, Q1.6 (C1), R7.1, SW1.2
/GK: D2.6 (KR), R14.1
/I34_pico: IC1.9 (NC_3)
/I35_pico: IC1.10 (NC_4)
/I36_pico: IC1.4 (NC_1)
/I37_pico: IC1.5 (IO2)
/I38_pico: IC1.6 (IO3), R16.1, U1.3 (SDA), U3.3 (SDI), U6.8 (SDA)
/I39_pico: IC1.7 (NC_2)
/IO2_pico: IC1.22 (IO8), R21.1
/IO4_pico: IC1.24 (NC_7)
/IO5_pico: IC1.29 (NC_10)
/IO8_pico: IC1.28 (NC_9)
/IO12_pico: IC1.19 (IO5), J3.3
/IO13_pico: IC1.20 (IO6), J3.4, R17.1, U1.2 (SCL), U3.4 (SCK), U6.2 (SCL)
/IO14_pico: IC1.18 (IO4), J3.2
/IO15_pico: IC1.21 (IO7), J3.5, R3.1
/IO19_pico: IC1.33 (NC_12)
/IO21_pico: IC1.35 (NC_14)
/IO22_pico: IC1.34 (NC_13)
/IO25_pico: IC1.15 (NC_5)
/IO26_pico: IC1.16 (IO10)
/IO27_pico: IC1.17 (NC_6)
/IO32_pico: IC1.12 (IO0), R15.2
/IO33_pico: IC1.13 (IO1), R14.2
/RK: D2.4 (KR), R3.2
/RTS: J6.2, Q1.1 (E1), R5.1
/RTX0: J5.2, R2.2
/TDX0: J5.1, R1.2
/USB_D+: IC1.27 (IO19), R12.2
/USB_D-: IC1.26 (IO18), R13.2
/V_USB: C8.1, J1.A4 (VBUS), J1.A9 (VBUS), J1.B4 (VBUS), J1.B9 (VBUS), J4.1 (VBUS), U2.1 (EN), U2.4 (VIN)
GND: C1.2, C2.2, C3.2, C4.1, C5.2, C6.2, C7.2, C8.2, C9.2, C10.2, D1.2 (A2), IC1.1 (GND_1), IC1.2 (GND_2), IC1.11 (GND_3), IC1.14 (GND_4), IC1.36 (GND_5), IC1.37 (GND_6), IC1.38 (GND_7), IC1.39 (GND_8), IC1.40 (GND_9), IC1.41 (GND_10), IC1.42 (GND_11), IC1.43 (GND_12), IC1.44 (GND_13), IC1.45 (GND_14), IC1.46 (GND_15), IC1.47 (GND_16), IC1.48 (GND_17), IC1.49 (GND_18), IC1.50 (GND_19), IC1.51 (GND_20), IC1.52 (GND_21), IC1.53 (GND_22), IC1.54 (GND_23), IC1.55 (GND_24), IC1.56 (GND_25), IC1.57 (GND_26), IC1.58 (GND_27), IC1.59 (GND_28), IC1.60 (GND_29), IC1.61 (GND_30), J1.A1 (GND), J1.A12 (GND), J1.B1 (GND), J1.B12 (GND), J1.S1 (SHIELD), J2.2, J3.6, J4.5 (GND), J4.6 (Shield), R9.1, R10.2, R11.1, R19.1, R20.1, SW1.1, SW2.1, U1.4 (VSS), U1.5 (GND), U2.2 (GND), U3.1 (GND), U3.5 (SDO), U3.7 (GND), U4.2 (GND), U5.2 (GND), U5.5 (GND), U6.3 (GND), U6.5 (PGND)
unnamed: IC1.30 (RXD0), R2.1
unnamed: IC1.31 (TXD0), R1.1
unnamed: L2.1, U2.3 (SW)
unnamed: Q1.2 (B1), R4.2
unnamed: Q1.5 (B2), R5.2
unnamed: C11.2, R8.1, R9.2, U2.5 (FB)

Notes on the sheet:
4: BMP688 Temp/Humidity/Pressure/VOC, Light
AS7341-DLGM
BME688
ESD
JTAG
Set the module to UART Download mode by pulling IO0 (pulled up by default) and IO2 (pulled up by default) low. The chip IOs are pulled down internally by default.
pin compatable with ESP32-PICO-MINI-02
Power, Reset and Boot
Mounting holes are used for assembly as well as injection molding alignment
Configuration
Located near processor
1: SHTC3 Temp/Humidty
25mil
Strapping pins GPIO2 GPIO8 GPIO9 GPIO10
Connectors and LED
3: BME280 temp/humidity/pressure
RTC
2: BMP280 Temp/Pressure, SHTC3 Temp/Humidity
Temp/Humidity/light/VOC/CO2 option
Porex PM6M material, or teflon plumbing tape
can't use Ixx GPIO lines

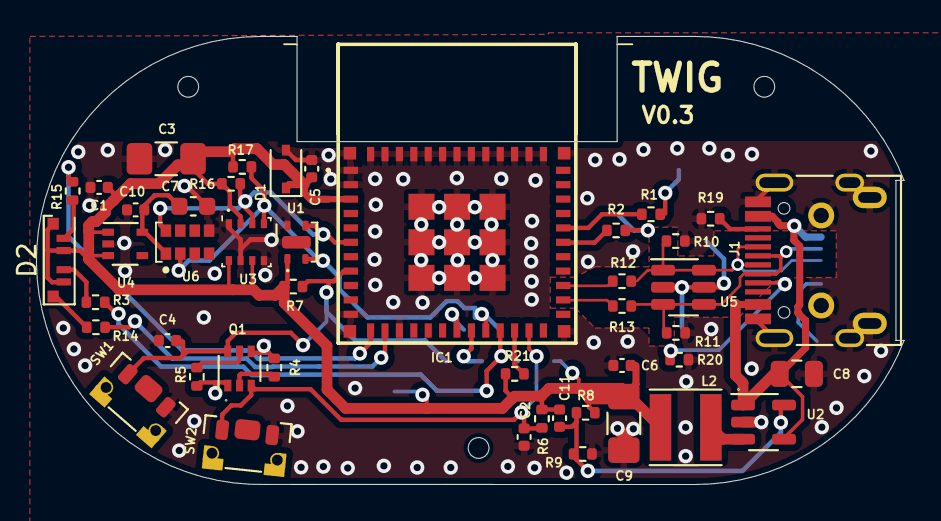
[picture p53: board temp sensor.kicad_pcb from above]

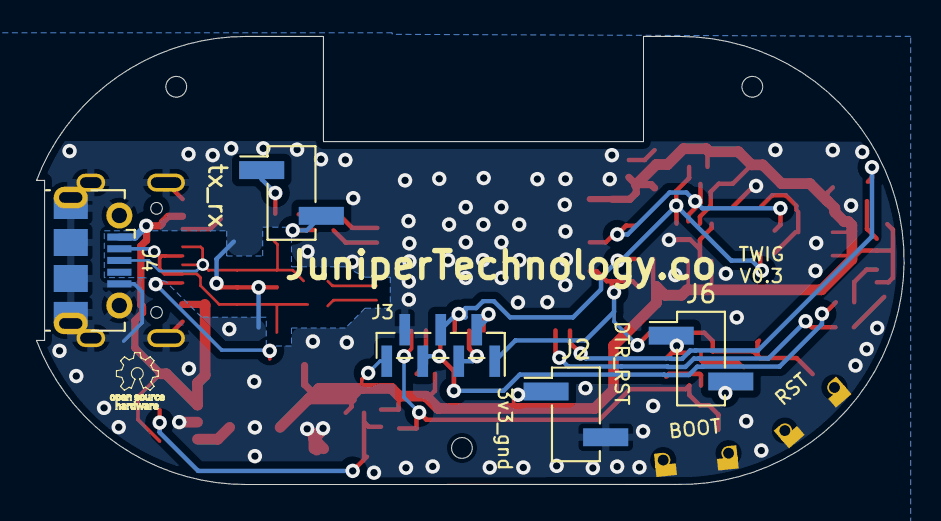
[picture p54: board temp sensor.kicad_pcb from below]

Board: 2 copper layers, 48.2 x 24.9 mm, 56 parts (5 on the bottom side), 33 nets.
