juniper-garden/twig_temp_humidity_sensor/(commit log)

2021-04-24 initial commit
    Added initial files to the repo
    [temp sensor.kicad_pcb, temp sensor.sch]
2021-05-01 added several parts, associated footprints, added todo list
    [temp sensor.sch]
2021-05-01 assigned designators Signed-off-by: lokimetasmith <lokimail@gmail.com>
    [temp sensor.sch]
2021-05-01 updated pdf
    [temp sensor.sch]
2021-05-04 minor update
    [temp sensor.kicad_pcb, temp sensor.sch]
2021-05-06 initial layout and silk screen options
    [temp sensor.kicad_pcb, temp sensor.sch]
2021-05-06 minor layout update and pic of humidity sensor cover concept
    [temp sensor.kicad_pcb]
2021-05-08 layout and part changes
    [temp sensor.kicad_pcb, temp sensor.sch]
2021-05-11 bom and pcb changes, need to add a switch still.
    [temp sensor.kicad_pcb, temp sensor.sch]
2021-05-12 added alt parts Signed-off-by: lokimetasmith <lokimail@gmail.com>
    [temp sensor.sch]
2021-05-12 lots of layout changes, optimized RF pathway, adjusted pinout, still working on ESP32 pinout
    [temp sensor.kicad_pcb, temp sensor.sch]
2021-05-13 updated schematic for updated parts
    [temp sensor.kicad_pcb, temp sensor.sch]
2021-05-15 updated bom
    [temp sensor.kicad_pcb, temp sensor.sch]
2021-05-16 exported gerbers, initial board spin
    [temp sensor-B_Cu.gbr, temp sensor-B_Mask.gbr, temp sensor-B_Paste.gbr, temp sensor-B_SilkS.gbr, temp sensor-Edge_Cuts.gbr, temp sensor-F_Cu.gbr, temp sensor-F_Mask.gbr, temp sensor-F_Paste.gbr]
2021-05-17 minor cosmetic updates
    [temp sensor.kicad_pcb, temp sensor.sch, temp sensor.xls]
2021-06-15 first crack at v2
    [temp sensor print.xls, temp sensor.sch, temp sensor.step, twig potting options.FCStd]
2021-06-17 switched resistors
    [temp sensor.sch]
2021-06-17 working on switch footprint
    [temp sensor.sch]
2021-06-20 added slot, updated led pins, updated buttons, still working on jtag and which IO to use
    [temp sensor.sch]
2021-06-22 updated footprints for switches, adjusted layout and cleaned up traces.
    Needs review but should be ready for second spin.
    [temp sensor.kicad_pcb, temp sensor.sch]
2021-07-06 added layout for usb C, lots of little changes to spacing. Still working out how much voltage protection is nessisary for usb-c
    [temp sensor.kicad_pcb, temp sensor.sch]
2021-07-08 added fuse and some layout changes
    [temp sensor panel v2.kicad_pcb, temp sensor.sch]
2021-07-12 Mostly all done, with Rev2. need to do final schematic review and logo
    [temp sensor.kicad_pcb, temp sensor.sch]
2021-07-13 reworked the layout to improve impedance, or so I hope.
    [temp sensor.kicad_pcb, temp sensor.sch]
2021-07-14 adding graphics and fab notes.
    [temp sensor.kicad_pcb]
2021-07-14 updated bom, exported gerbers
    [OSHW-Logo-R2000.dxf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]
2021-07-16 initial work on gerber files, there's an error where arches aren't rendered correctly
    [combined.drl, combined.gbl, combined.gbp, combined.gbs, combined.gm1, combined.gtl, combined.gtp, combined.gts]
2021-07-20 gerbers as ordered for the panelized version 0.2 of the board
    [combined.drl, combined.gbl, combined.gbp, combined.gbs, combined.gm1, combined.gtl, combined.gtp, combined.gts]
2021-08-30 updated drawings for readablity, exported pdf bom and manufacturing documentation
    [temp sensor.kicad_pcb]
2021-09-21 updated models, added in zipped gerbers and 3D step files
    [ESP32-pico-mini-02 v2.step, HRO_TYPE-C-31-M-12.step, temp sensor.kicad_pcb, temp sensor.step, temp sensor_0v2.xls, twig-BOM_JLCSMT.xlsx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]
2021-10-06 updated manufacturing notes
    [temp sensor_0v2.xls]
2021-10-07 updated design files
    [temp sensor-B_CrtYd.gbr, temp sensor-B_Cu.gbl, temp sensor-B_Fab.gbr, temp sensor-B_Mask.gbs, temp sensor-B_SilkS.gbo, temp sensor-Cmts_User.gbr, temp sensor-Dwgs_User.gbr, temp sensor-Eco1_User.gbr]
2021-10-07 slight change to documentation update, added dimensions of the board to help assist in fabrication
    [temp sensor.kicad_pcb]
2021-10-13 added full outline and mold alignment holes
    [temp sensor.kicad_pcb, temp sensor.sch]
2021-10-14 updated silk to v0.2.1 for minor update to v0.2
    [temp sensor.kicad_pcb]
2021-10-24 staging for 0.3, added footprint for everlight rgb-led (will shine into the board as opposed to out of board) moved esp32 closer to the edge to match edge graphic, no major circuit change from 0.2
    [temp sensor.kicad_pcb, temp sensor.sch]
2021-10-24 documentation updates
    [temp sensor-B_CrtYd.gbr, temp sensor-B_Cu.gbl, temp sensor-B_Fab.gbr, temp sensor-B_Mask.gbs, temp sensor-B_Paste.gbp, temp sensor-B_SilkS.gbo, temp sensor-Cmts_User.gbr, temp sensor-Dwgs_User.gbr]
2021-10-25 updated 0.3 bom and schematic
    [temp sensor.sch, twig_0v3-BOM_JLCSMT.xlsx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]
2022-01-03 Revert "Revert "Revert "version 0.4 includes JLCPCB changes and overmolding options"""
    This reverts commit 40e6c7e4762de2b8bfb4e926ce4de56b718958bf.
    Adds many features for jlcpcb
    [temp sensor.kicad_pcb, temp sensor.sch]
2022-01-04 added step, flipped bme280 select to match adafruit bme280 breakout board
    [temp sensor.sch]
2022-02-21 updated to kicad 6, lots of changes
    [temp sensor.kicad_pcb, temp sensor.kicad_sch, temp sensorv3.step]
2022-02-21 exported v3 gerbers
    [temp sensor-B_Courtyard.gbr, temp sensor-B_Cu.gbl, temp sensor-B_Fab.gbr, temp sensor-B_Mask.gbs, temp sensor-B_Paste.gbp, temp sensor-B_Silkscreen.gbo, temp sensor-Edge_Cuts.gm1, temp sensor-F_Courtyard.gbr]
2022-02-21 updated user.drawings with sensor window cutout
    [temp sensor-B_Courtyard.gbr, temp sensor-B_Cu.gbl, temp sensor-B_Fab.gbr, temp sensor-B_Mask.gbs, temp sensor-B_Paste.gbp, temp sensor-B_Silkscreen.gbo, temp sensor-Edge_Cuts.gm1, temp sensor-F_Courtyard.gbr]
2022-02-22 added usb 3d step model
    [USB4105-GF-A--3DModel-STEP-56544.STEP, temp sensor.kicad_pcb]
2022-03-10 added support for AS7341 and removed support for one of the temp/humidity sensors
    [AS7341-DLGT.step, QLS6A-FKW-CNSNSF043--3DModel-STEP-56544.STEP, TL6340AF160Q.stp, temp sensor.kicad_pcb, temp sensor.kicad_sch, twig potting options edit.FCStd, twig potting options.FCStd]
2022-03-18 working to add the 3D overmold cutout to the step file
    [Unnamed-sensor_window_cutout002 (Solid).step, sensor window cutout.scad, sensor window cutout.stl]
2022-03-21 added cutout model, minor changes to pcb
    [temp sensor.kicad_pcb, temp sensor.kicad_sch]
2022-03-24 added led cutout block
    [Unnamed1-led_window_cutout001 (Solid).step, led window cutout.FCStd, led window cutout.scad, led window cutout.stl, sensor window cutout.FCStd, sensor window cutout.scad, temp sensor led and sensor port cutout windows.step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]
2022-04-11 cribbed schematic corrections from https://github.com/esp-rs/esp-rust-board/tree/master/hardware/esp-rust-board
    tweaked part layout, added back in zener 3v3 diode, added filter diode, and made minor tweaks.
    [temp sensor-B_Courtyard.gbr, temp sensor-B_Cu.gbl, temp sensor-B_Fab.gbr, temp sensor-B_Mask.gbs, temp sensor-B_Paste.gbp, temp sensor-B_Silkscreen.gbo, temp sensor-Edge_Cuts.gm1, temp sensor-F_Courtyard.gbr]
